sinara-hw/Sayma_AMC/MC100EP_levels.PNG

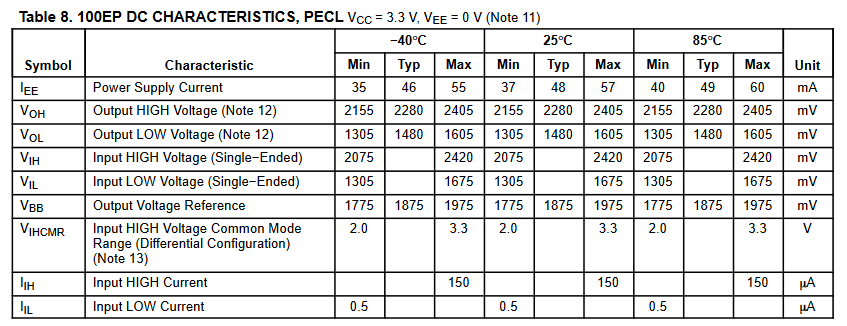
MC100EP_levels.PNG
