sinara-hw/Sayma_AMC/TPS53353-layout.tif

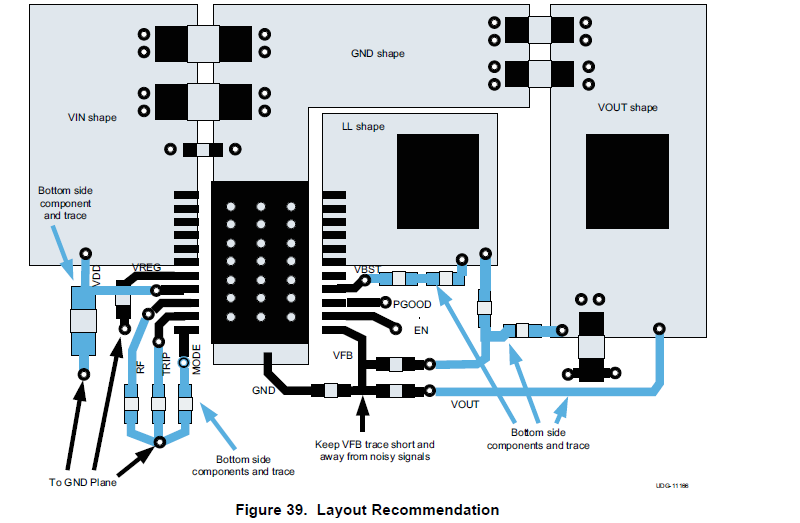
TPS53353-layout.tif
