sinara-hw/Sayma_AMC/TPS53353.png

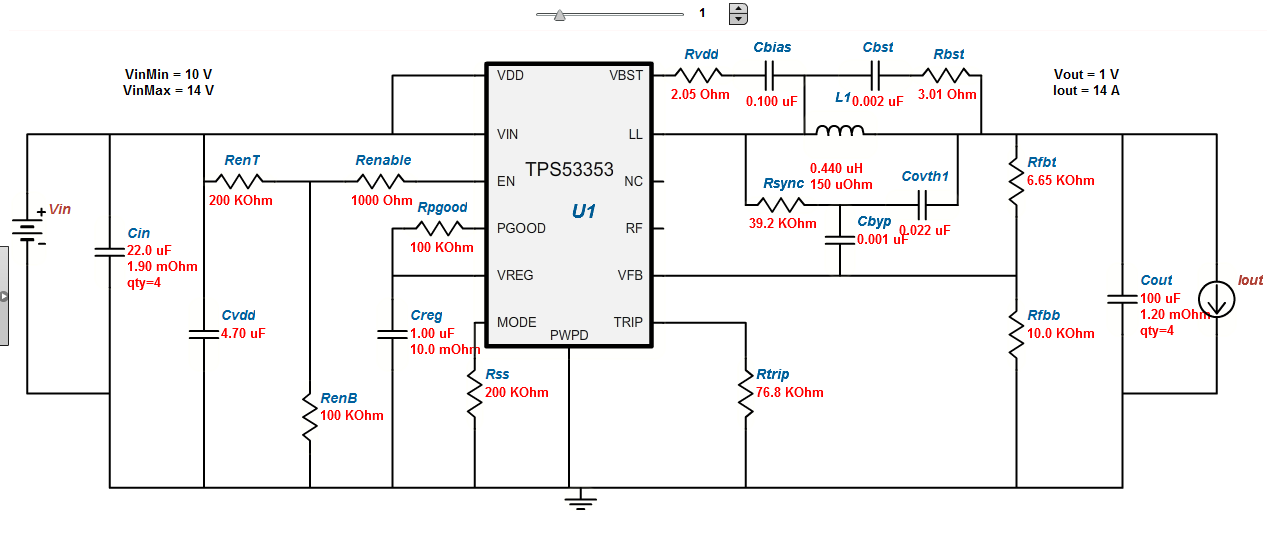
TPS53353.png
