sinara-hw/Sayma_AMC/(threads)

Thread 60 (2017-05-30):

Sayma AMC - Version 1 errata

gkasprow, 2017-05-30:
Mechanical:
- [x] use 2mm higher J14 connector.  Wurth 621 010 210 21
- [x] add cutout in the panel under SFP cage to make module removal easier
- [x] make 3.5mm switch hole in front panel
- [x] panel switch hole = 3.5mm
- [x] sfp cutout 0.5mm bottom
- [x] make USB connector hole touch panel edge
- [ ] move L23 away from ufl connector
- [x] Move power supply status LEDS from bottom side of board to top edge of board (like on Sayma_RTM) so that they're visible from top of crate.

BOM:
- [x] mark R257 DNP
- [ ] add SMA insulating washer to the panel
- [x]  wrong type of guiding socket  - should be "1" instead of '8'
- [x] IC24=DNP
- [x]  R183=DNP
- [x]  remove C282
- [x] AMC: make C221 0R to enable internal reference
- [x] install R507 by default
- [x] Include FMC standoffs and screws in BOM.

I2C:
- [x] connect some I2C pullups to P3V3 instead of P3V3MP

JTAG:
- [x]  add 0R resistors on SWD/JTAG or FET that disconnects SCANSTA during CPU flashing
- [x] add JTAG MPSEL status/control to MMC pin E8
- [x] fix issue with JTAG switchover. After changing MMPSELB1/B0 SCANSTA needs reset to apply settings
- [x] to enable FLASH programming operation, disconnect it from RTM FPGA. Add termination.
- [x] fix second FLASH CSn connection - use pin G26 for CSn instead of K21

USB:
- [x] T23 source = GND
- [x] Insertion/removal of USB cable resets MMC and power supply. Feature: add RC delay circuit or voltage supervisor. Quick fix: jumper on reset signal on T21
- [x] 100k resistor on T23 gate

Ethernet:
- [x] Make sure that TX CLK goes first before Ethernet PHY reset. Feature: trigger it by CONFIG DONE or leave as it is.
- [x] MAX PHY need to have clock delivered to both MII TX CLK and GTXCLK
- [x] make sure that PHY TRSTn is low
- [x] make sure that PHY LOS is low
- [x] Apply Etheret fix #327

Power:
- [x]  feature: add slow start for P12V FMC and RTM 1k5 + 1uF
- [x] add slow start MOSFET in parallel to the current limiting resistor.
- [x] add 3v3mp LED
- [x] add 12V ext TVS
- [x]  LD11 current too low, R242 = 10k
- [x] increase the VCCINT to 0.975V
- [x] 0.9V generation - R243+R244=5k1
- [x]  swap PSIO2 and GPIO0 - resistors R208, R205

Schematics:
- [x] MAX6642 address is 0x48, not 0x24 - change schematic annotation
- [x]  fix schematic symbol of SATA connector - pins numbering
- [x]  RTM IC40 address is 0x4B - change comment on schematics
- [x] Fix illegible blocks in schematic (cf  #231)
- [x] Zero-index all channels (SMAs, FMCs, SFPs, etc)
- [x] Rename USR_UART_P/N - UART is not a differential signal

Clocks:
- [x] OSC3 = 510BBA200 instead of 510ABA200 or add 2x200R to GND
- [x]  wrong connection of SD pins of LTC6957. They must be tied low instead of high.
- [x] re-route Si5324 clocks so CLK1 and CLK2 have same skew - are connected to clock buffer.

Other:
- [x] Assign clock capable pins on FMCs
- [x] wrong pin numbering on J13 silkscreen
- [x]  swap T20, T21 drains or gates
- [x] 10k pullup on SFP pin 9
- [x] The SMA_IO1_DIR MOSFET incorrectly controls the SMA_IO2 channel, and vice versa.

RTM:

- [x] replace MAX6642ATT90+T with MAX6642ATT98+T on RTM - change I2C address from 0x48 to 0x4C (already in RTM errata)

hartytp, 2019-03-11:
> There are only mechanical and PCB left

Great. Are the AMC/RTM schematics ready to review then apart from the HMC830 active loop filter OpAmp choice?

hartytp, 2019-03-11:
> I'll move it to Sayma_AMC repo

Thanks. While you're at it, would you mind reviewing all other Sayma related issues in the Sinara repo and closing/moving them as appropriate?

Closed 2019-03-25.

Thread 61 (2018-05-07):

SFPs get stuck in Sayma

sbourdeauducq, 2018-05-07:
And pins of the cage get bent during removal. See the first 3 pins at the bottom of the cages on the picture:
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

gkasprow, 2019-03-25:
I added panel cutout to solve the issue
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

Closed 2019-03-25.

Thread 44 (2018-12-11):

Sayma AMC v2 design changes

gkasprow, 2018-12-11:
Sayma AMC v2 apart from fixing issues reported in #600 undergoes major modifications:
- Ethernet PHY
- Clock distribution with [WR support](https://github.com/sinara-hw/meta/issues/15)
- FTDI JTAG -copied from Kasli
- JTAG switch - copied from Xilinx devkit, but with AMC access

gkasprow, 2019-02-25:
added clock path between CDR and SDRAM banks to enable Xilinx IP using during production tests
#30

gkasprow, 2019-02-25:
added Silabs CDR test points

gkasprow, 2019-02-25:
added TVS #13

gkasprow, 2019-02-25:
the output of Si5324 buffer routed to the bank 226

sbourdeauducq, 2019-02-26:
> the output of Si5324 buffer routed to the bank 226

Which output of Si5324?
Why?

gkasprow, 2019-02-26:
to make sure every GTX can drive DRTIO

sbourdeauducq, 2019-02-27:
I assume you mean the output of the CDR clock mux/distributor IC44.

OK. Not strictly necessary (the JESD transceivers do not need det-lat with the RTIO clock and also can be clocked from the RTM), but fine to have if it's easy and doesn't break anything.

gkasprow, 2019-03-11:
I think we can close it. It's hard to track all changes since the design is so different from v1.

Closed 2019-03-11.

Thread 1 (2018-12-12):

Sayma AMC v2 schematic review

gkasprow, 2018-12-12:
@jbqubit I've just published schematics and sources of Sayma AMC v2. I figured out that only a few files are necessary to open the design. Remaining >1k files are not needed. This reduces significantly required space on github. For some reason previous versions of Xpedition tool needed some of them.

https://github.com/sinara-hw/Sayma_AMC/releases/tag/v2.0rc1

gkasprow, 2018-12-13:
not yet, I will finish RTM till the end of this week. There are a lot of changes. Today I will post Metlino schematics. I'm just doing cosmetics.

gkasprow, 2018-12-13:
I  found and fixed some critical error. I'm just curious if somebody finds it during review :)

gkasprow, 2018-12-13:
in the meantime I found and corrected a few issues:
- error in JTAG switch control logic
- too high helper DCXO output level in case of LVPECL oscillator used
- @tprzywoz found issue with JTAG net labels

hartytp, 2018-12-13:
Schematics look much nicer than the last design revision. New release of EE?

hartytp, 2018-12-13:
@WeiDaZhang please can do you do a full design review of the WR on Sayma AMC?

hartytp, 2018-12-13:
I had a look at this for things that I should review for Sayma AMC. The only things I can see are:
- WR oscillators and related connections (I will not do the transciever/FPGA clocking, that needs to be done by @sbourdeauducq)
- RTM connector pin out

Let me know if anyone is expecting me to look at anything else.

gkasprow, 2018-12-13:
I played manually with font setting during  pdf export :)

jbqubit, 2018-12-13:
Thanks @gkasprow !

hartytp, 2018-12-14:
> RTM connector pin out

https://github.com/sinara-hw/Sayma_AMC/issues/3

> WR oscillators and related connections (I will not do the transciever/FPGA clocking, that needs to be done by

https://github.com/sinara-hw/Sayma_AMC/issues/5

hartytp, 2018-12-14:
@gkasprow one other thing to consider:
- should we replace the FP SMAs with MMCXs? In the last revision I found it a bit of a pain to tighten SMAs because the density of components was so high
- if there we make this switch then let's move the WR clock input to the FP, using an MMCX for that as well

gkasprow, 2019-02-25:
I updated SMAs with MCX

Closed 2019-02-25.

Thread 3 (2018-12-14):

AMC <-> RTM connections

hartytp, 2018-12-14:
- On Sayma RTM v1.0 there are 10 unused diff pairs on the RTM connector. On the AMC these connect to: GTP8RX-GTP10RX and SYNCOUT{1,2}1
- On Sayma RTM v2.0 we will completely remove (i.e. not just DNP) the JESD ADCs. This will free up an additional 11 diff pairs on the RTM that are currently connected to: GTP{0-7}RX; ADC{0,1}_SYNC; FPGA_ADC_SYSREF
- So, assuming I've counted that correctly, that leaves us with 21 diff pairs to play with.
- On Sayma v2.0 we need to connect more IO to the AFE mezzanines for LVDS ADCs etc. I consider this IO to be part of the "core functionality" of Sayma, since localized control loops (e.g. for laser intensity stabilization) are really important in our experiments
- AFAICT it is not possible to use transceiver TX/RX lines as LVDS, so if we want to repurpose the unused GTP RX lines then we will need to move them onto FPGA SelectIO pins (make sure to include a couple of CC/GC pins)
- Side note: I would be (pleasantly) surprised if using 0R resistors to switch these lines between MGT and LVDS will work from a SI perspective, so my assumption is that the choice of MGT v LVDS will not be a matter of population options

Issues that need considering:
1. How many free pins on the FPGA that we can use for LVDS?
2. Are there likely to be other uses for Sayma AMC that would need the GTX lines? e.g. are people likely to want to combine Sayma AMC with a RTM which breaks out these GTX lines to SPFs for use as a WR/DRTIO switch? My guess is that they won't and, in any case, if people do want this kind of switch, it might be easier to use a really simple AMC combined with FMC<->SFP adapters.

Anyway, once we have answers to these questions we can finalize the layout on the RTM connector.

Other notes:
- Let's try to keep as many of the LVDS lines in the same bank as possible to avoid timing issues
- let's try to delay match the LVDS lines
- need at least two CC/GC LVDS lines (e.g. AFE ADCs)
- On the RTM: ensure that routing of LVDS lines is optimized to minimise cross-talk with analog signals (particularly with the DAC RF outputs).
- FAT_PIPE2 is the link to the second MCH slot in the uTCA rack. This will not be used in ARTIQ, so we can steal lines from this.
- see https://github.com/sinara-hw/sinara/issues/414

hartytp, 2018-12-14:
Other comments:
- final pin choice needs a design review by @sbourdeauducq or @jordens to verify that we're doing things sensibly for use with SU-Servo type loops etc
- Assuming that there are banks on the RTM FPGA that work with LVDS signals, we could consider routing some IO to the RTM FPGA and some directly to the AFE mezzanines. Let's wait and see how much IO we have to play with before we make a decision about this

hartytp, 2018-12-14:
Additionally:
- Now that we don't have an HMC7043 on the RTM, what should we do with GT_CLK{1,2}? We could route the 125MHz reference clock from the RTM to the AMC, but it's not clear that would be useful (and in any case, at some point the RTM ref clock should be derived from the AMC via WR so there is no point routing it back again). Or, we could just re-purpose these as additional LVDS IO. This needs to be considered as part of a review of how to drive the transceiver MGTREF pins in Sayma v2.0
- note to self: in the current version of ARTIQ
  - RTM_FPGA_LVDS2 is used for SERWB TX
  - RTM_FPGA_LVDS1 is used for SERWB RX
  - RTM_FPGA_USER_IO is used for SERWB CLK
  - in the new version of ARTIQ, SERWB will not be used, so these lines become general purpose user LVDS IO
  - @gkasprow why is the naming not consistent here? Why is RTM_FPGA_USER_IO not named RTM_FPGA_USER_IO_0?
  - RTM_MASTER_AUX_CLK is not currently used by ARTIQ and I don't think there are any plans to use it in the future. Can we use this as general purpose LVDS for the AFE mezzanines?
  - NB I am judging pin usage in ARTIQ from https://github.com/m-labs/migen/blob/master/migen/build/platforms/sinara/sayma_rtm.py

hartytp, 2018-12-14:
> we can have additional 4 LVDS pairs. They are routed to FatPipe2 because I had not better idea what to do with them

Great!

That's a good start, but I'm greedy and want more :)

e.g. I'd like to be able to put 1 LVDS ADC  on each AFE mezzanine, so two total. Ideally we should have enough IO for 2x (CLK_IN, CLK_RET, 2xSDO) = 8 lines, as well maybe 1-2 extra lines for future use.

--

As I said, there are also a few more LVDS lines we can steal like IO_L22P_T3U_N6_DBC_AD0P_66/IO_L22N_T3U_N6_DBC_AD0P_66 (SYNCOUT11) etc.

Let's rename those all USER_LVDS_X or similar (convention: RTM_FPGA_LVDS_X goes to the RTM FPGA, USER_LVDS_X goes to the AFE mezzanines). Let's make sure we've re-purposed as many IOs as possible for general-purpose LVDS links.

> I would simply connect MGT Rx lines to the analog mezznines.

Do you think SI will be okay once they've gone through the FMCs and onto an FR4 PCB?

Anyway, my preference would be to maximise the amount of LVDS IO we have going to the AFE mezzanines, even if that means loosing a few transceiver lines (realistically, I think it's unlikely that anyone will ever use Sayma with a JESD ADC, so these transceivers are unlikely to be used).

Let's start with the question "what is the most LVDS lines we can use on the AMC FPGA" and then decide about transceivers.

> Take into accout that RTM_FPGA_GTP_Rx1 / TX1 are also LVDS.

If they are LVDS why are they named GTP? I thought that transceivers can't be used for LVDS. If they are just normal select IO pins then let's rename them to RTM_FPGA_LVDS_x.

hartytp, 2018-12-14:
Which transceiver lines will be used for RTM DRTIO?

hartytp, 2018-12-14:
One other thing: I think that LVDS links to the AFE mezzanines are more useful than links to the RTM FPGA.

Once we've decided how many AMC <-> RTM LVDS links we have to play with, we can divide them between AFE and FPGA links.

gkasprow, 2018-12-14:
We can also forward AMC LVDS links via RTM FPGA LVDS IOs as well.

gkasprow, 2018-12-14:
We used LVDS lines to connect to RTM FPGA GTP to stream DRTIO. It is possible, but GTP to GTP is much easier to implement.

jordens, 2018-12-14:
Could you file issues for checking individual questions like the suservo compatibility thing above?

hartytp, 2018-12-14:
> Could you file issues for checking individual questions like the suservo compatibility thing above? And assign to me.

Yes, apologies for the mega issue. Will break out later this weekend.

hartytp, 2018-12-14:
> We can also forward AMC LVDS links via RTM FPGA LVDS IOs as well.

Yes, this was discussed before. We can do this but (a) it's mildly inconvenient since it means changes to the RTM gateware to configure (b) we're currently very short on pins on the RTM FPGA, there aren't enough pins to route all IO via the FPGA (c) for things like fast LVDS ADCs we need to be careful of timings when using FPGAs as buffers.

Essentially, it's possible, but for now I'd prefer to route IO directly to the AFE.

> We used LVDS lines to connect to RTM FPGA GTP to stream DRTIO. It is possible, but GTP to GTP is much easier to implement.

IIRC that was the plan for Sayma v1.0. In Sayma v2.0 DRTIO will be accomplished using transceivers and there will be no DRTIO using LVDS links.

hartytp, 2018-12-17:
In https://github.com/sinara-hw/sinara/issues/564#issuecomment-447679857 @gkasprow said:

> We already have 12 LVDS lines from Sayma AMC FPGA

Which 12 lines are these? I'd like to finalize the RTM <-> AMC connectivity before we start designing the AFE so that I know what we have to work with.

gkasprow, 2018-12-17:
We can  make some of GTP Rx lines double use with capacitor and extend the LVDS count to 12 lines.

jbqubit, 2018-12-18:
>IIRC that was the plan for Sayma v1.0. In Sayma v2.0 DRTIO will be accomplished using transceivers and there will be no DRTIO using LVDS links.

I'm talking with @sbourdeauducq by email about this. He can provide details. DRTIO will be via transceivers on Sayma v2.0.

gkasprow, 2018-12-18:
So far I assigned only 2 LVDS lines to the RTM FPGA and rest of them routed to AFE

gkasprow, 2019-02-25:
I think we can close it.

Closed 2019-02-25.

Thread 4 (2018-12-14):

Schematics cosmetics:

hartytp, 2018-12-14:

marmeladapk, 2018-12-17:
I'll add some points from https://github.com/sinara-hw/sinara/issues/209 schematics section that are not resolved:

- [ ] IC40 looks like 0x49 on old RTM schematics (address is changed in AMC table to 0x4B)
- [ ] not zero indexed:
 - uart on top
 - fat pipie (though port0 - port3 may be fat pipe 0)
 - SMA I/O
 - CDR_CLK_CLEAN
 - FMC
 - SFP
- [ ] USR UART not renamed

marmeladapk, 2018-12-19:
I think, that this issue could aggregate issues, that could be fixed after boards are send to manufacturer as these have no effect on layout.

Other cosmetics:

- [ ] Exar GPIO0: general input -> general output?
- [ ] Exar: HW_PWR_good net is used now as enable signal
- [ ] P0V9 should be probably renamed to P0V95 (but net P0V95 already exists, could it be merged? VCCBRAM seems to have low current draw, at least 31 mA is noted on schematics)
- [ ] no notes about softstart settings, reset thresholds, R509 which is DNP and what happens if we insert it,
- [ ] no maximum current noted on molex 12V connector

tprzywoz, 2018-12-20:
JTAG_Configuration:
- [ ] Net label FMC1_PRSNT -> FMC1_PS# (like RTM_PS#)

marmeladapk, 2018-12-21:
- [ ] OSC3 has no value or part number

atcher0, 2018-12-21:
- [ ] USB SERIAL QUAD page is described as sheet 31 of 30; DUAL_IO_TTL_BUFFER page is not numbered
- [ ] OSC4_PWR labeled net is connected to OSC2; OSC3_PWR net is connected to OSC1
- [ ] many MMC not connected pins are not marked NC
- [ ] ETH2_RGMII bus is not zeo-indexed
- [ ] no notes about IC11, IC12 direction settings, FT4232H hard-wired settings, TPS3808 voltage threshold
- [ ] USB_JTAG bus should be marked as INOUT not OUT (JTAG configuration page)
- [ ] PHY_CFG bus should be marked as INOUT not IN (MDIO - INOUT; MDIO_MODE - OUT) (ETH PHY page)

marmeladapk, 2019-01-07:
- [ ] ADCLK948 Q4 and Si5324 CKOUT1 are not marked NC

tprzywoz, 2019-01-08:
Change position of AMC_ADD and AMC_En net labels
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

Thread 5 (2018-12-14):

WR connections

hartytp, 2018-12-14:
- @gkasprow what is the additional cost of making J34 + J35 MMCX instead of UFL? Makes the connections a bit more robust
- @gkasprow why does it say "NOT USED" by IO_L24{P,N}_T3U_N1{0,1}_66? These are used for the recovered clock.
- not important, but on the current Kasli schematics we don't connect to Si5324 INT_C1B. On Sayma you connect that to the AMC FPGA. AFAICT, we don't need this line, so we could drop it to save an FPGA pin.
- currently, the Si5324 CLKOUT1 is not connected to anything. Should we connect that to an FPGA MGTREF pin? Now that we don't have the HMC7043 on the RTM, we don't have a programmable clock source to generate the transceiver clock (due to limitations of the transceiver PLL, we may need different clock frequencies for different JESD line rates). @sbourdeauducq should make a decision on this
- @gkasprow what is AMC_TELECOM_CLOCK?
- replace 100k resistor to ground by J3 with 0R
- thinking about this a bit more, I'm concerned that the decoupling between the decoupling between the various P3V3_CDR supplies. The helper DCXO runs at a different frequency to the master, so any power-supply rail coupling will add close-in spurs onto the master. Similarly, if the Si5324 is used to drive a MGTREF, it could be used to produce a different frequency to the WR PLL. I think the best approach would be to produce the circuit the way it is, test it carefully when the boards arrive and only add more filtering/LDOs if we find an issue. On the other hand, an extra LC filter is cheap and may avoid issues. What do you think @gkasprow
- the divider for the main DCXO is not correct. With the connections you have, the ADCLK948 internal 50Ohm termination is enabled, so the 200Ohm source impedance will give quite a low signal. Either disable the ADCLK948 termination (but then be careful about the distance between the DCXO an ADCLK948) or use a smaller source impedance.
- for the helper DCXO please add a note indicating which logic standard and termination should be used. I assume you want this to be used with unterminated LVCMOS? If so, then be careful in the layout to avoid a long length of unterminated trace

Notes on my review:
- [x] Si5324 connections look good (match Kasli)
- @WeiDaZhang are you happy with the FPGA pin used to drive REC_CLOCK?
-

marmeladapk, 2019-01-07:
Helper DCXO doesn't go to 2,5V bank as indicated in the note, it goes to HP. Output divider should probably also be changed.

marmeladapk, 2019-01-07:
Why does helper DCXO have different short to ground (_N line) than main DCXO?

marmeladapk, 2019-01-07:
IC40 OE should be connected as in IC39 (R383 connected to the left side of R385)

marmeladapk, 2019-01-07:
Should IN_SEL (ADCLK948) have pull-up/down resistor to select default?

tprzywoz, 2019-01-09:
As @marmeladapk said Helper DCXO go to 1.8 V bank, not 2.5 V.
Also Helper has both: DC coupling and DC bias voltage on FPGA input.

gkasprow, 2019-02-25:
>     * @gkasprow what is the additional cost of making J34 + J35 MMCX instead of UFL? Makes the connections a bit more robust

the same, done

>
>     * @gkasprow why does it say "NOT USED" by IO_L24{P,N}_T3U_N1{0,1}_66? These are used for the recovered clock.

fixed

>
>     * not important, but on the current Kasli schematics we don't connect to Si5324 INT_C1B. On Sayma you connect that to the AMC FPGA. AFAICT, we don't need this line, so we could drop it to save an FPGA pin.

It's already routed.
>
>     * currently, the Si5324 CLKOUT1 is not connected to anything. Should we connect that to an FPGA MGTREF pin? Now that we don't have the HMC7043 on the RTM, we don't have a programmable clock source to generate the transceiver clock (due to limitations of the transceiver PLL, we may need different clock frequencies for different JESD line rates). @sbourdeauducq should make a decision on this

we use HMC7043.
Shall I connect it to CLK1 of bank 226?

>
>     * @gkasprow what is AMC_TELECOM_CLOCK?
It is a clock delivered by MCH. In our case, it is delivered by WR  timing module that sits on the MCH.
>
>     * replace 100k resistor to ground by J3 with 0R

done

>
>     * thinking about this a bit more, I'm concerned that the decoupling between the decoupling between the various P3V3_CDR supplies. The helper DCXO runs at a different frequency to the master, so any power-supply rail coupling will add close-in spurs onto the master. Similarly, if the Si5324 is used to drive a MGTREF, it could be used to produce a different frequency to the WR PLL. I think the best approach would be to produce the circuit the way it is, test it carefully when the boards arrive and only add more filtering/LDOs if we find an issue. On the other hand, an extra LC filter is cheap and may avoid issues. What do you think @gkasprow

I added already L18 and L19 and 4.7uF || 1nF caps
We don't need low-frequency filtering, do we?

>
>     * the divider for the main DCXO is not correct. With the connections you have, the ADCLK948 internal 50Ohm termination is enabled, so the 200Ohm source impedance will give quite a low signal. Either disable the ADCLK948 termination (but then be careful about the distance between the DCXO an ADCLK948) or use a smaller source impedance.

changed to 49R9

>
>     * for the helper DCXO please add a note indicating which logic standard and termination should be used. I assume you want this to be used with unterminated LVCMOS? If so, then be careful in the layout to avoid a long length of unterminated trace

True, we use 1.8V LVCMOS. That's why 150R + 200R divider was used.
But it has a roughly 80Ohm output impedance.
The diff pair with one line grounded would have similar impedance, so that should work.

>

gkasprow, 2019-03-05:
I think we can close it.
The free clock output of Si5324 has other phase relationship than currently used one.
Moreover, we have 2 clocks connected between and bank 225 and 224
I also routed another copy of CDR clock to bank227 to enable clocking of all MGTs.

sbourdeauducq, 2019-03-05:
>  The free clock output of Si5324 has other phase relationship than currently used one.

Yes, it is important that all clocks should be derived from the *same* Si5324 output. Except in very special circumstances, the two outputs have a random phase relationship with each other after each Si5324 reboot.

Closed 2019-03-05.

Thread 6 (2018-12-17):

Servo AMC<->RTM connectivity requirements

hartytp, 2018-12-17:
Let's make sure that the AMC<->RTM connectivity is designed to support a SU-Servo type application, using the AFE ADCs to feedback onto the RF amplitude/phase/frequency.

NB software/gateware development is not funded for this. This issue is just about making sure the hardware can support this

jordens, 2018-12-18:
That would be great.
If the ADC is the same as on Sampler and is connected to the AMC FPGA, make sure that CLKOUT is a CC pin and that the SDO[ABCD] pairs are on the same bank as that pin. And signal levels and SI.
A sufficiently thorough design review and sign-off of the feasibility of the ADC use cases needs more discussion and specification. And funding.

hartytp, 2018-12-18:
Thanks for the clear summary @jordens

Given M-Labs current limited resources for design reviews, shall we assign checking this to Creotech / @marmeladapk. Reiterating the above, the things to check are:
1. we ideally need 12 LVDS links from the AMC FPGA to the RTM AFE mezzanines (2x{CLKIN, CLKOUT, SDO{A-D}}). It's probably okay if less IO is available, but it needs to be flagged during the high-level review and discussed
2. Check that all LVDS IO for each mezzanine is connected to the same bank of the AMC FPGA and that at least 1 CC pin is routed to each AFE mezzanine
3. Verify SI from the AMC FPGA to the AFE mezzanine is good for DDR signals at 125MHz.

jbqubit, 2018-12-18:
Thanks for the summary @hartytp!!

marmeladapk, 2019-01-28:
It seems that we have enough pins, however checking bank connectivity on AMC needs to wait until #34  is resolved.

gkasprow, 2019-03-06:
We have more LVDS than we need.

Closed 2019-03-06.

Thread 7 (2018-12-17):

Transceiver clocking

hartytp, 2018-12-17:
- How do we want to clock the AMC transceivers?
- more generally, are you happy with the clock connections on the AMC<->RTM connector? Do you want any other clock lines between the two boards? If so, what should they connect to?

gkasprow, 2018-12-17:
So far there are 2 clock input to the AMC MGTs + one general clock input for FPGA GC routed to the clock fanout on RTM.

gkasprow, 2018-12-17:
we can route it to the Si5324 input. Does it support zero skew buffer mode ?

gkasprow, 2019-02-25:
I added output of ADCLK948 to the free input of bank 226.

Closed 2019-02-25.

Thread 8 (2018-12-17):

AMC <-> RTM FPGA connectivity

hartytp, 2018-12-17:
This has been covered a bit in other threads, but we need to make sure that we have all the AMC FPGA <-> RTM FPGA connectivity that M-Labs want. This includes both allocating lines on the AMC <-> RTM connector and ensuring they are connected to appropriate FPGA pins.

gkasprow, 2018-12-17:
at the moment we have 2 LVDS pairs + 1 MGT pair.

gkasprow, 2018-12-18:
I managed to route 16 LVDS lines between AMC FPGA and mezzanines + 2 LVDS lines between AMC FPGA and RTM FPGA

gkasprow, 2018-12-18:
some of them would be shared with MGT Rx lines. So one can use them either as LVDS or JESD204B without issues, just by replacing capacitors.

gkasprow, 2018-12-18:
Let's route all 16 MGT Rx lines as LVDS or MGT.
I still have 7 LVDS lines that would be left as they are. In this way one can place on mezzanine even 8-lane JESD204B ADC when needed or decent speed serial ADC, i.e. 4x125MHz which needs 10 LVDS lanes.

hartytp, 2018-12-18:
Nice! Do we still have a transceiver to use for DRTIO?

Can you post a shot of the schematic with the AMC FPGA pin mapping for the AMC<->RTM connector, please?

> So one can use them either as LVDS or JESD204B without issues, just by replacing capacitors.

Cool. What frequency will that work up to?

gkasprow, 2018-12-18:
I will post once I make sure that I implemented changes on AMC, RTM and BaseMod.
It will work up to 1.5Gb/s easily, depends on speed grade.
I want to remove LVDS connection between FMC DP lane. We won't use it anymore and I will get GC inputs needed for AFE mezzanines. In this way we will get 8 fixed LVDS links + 16 shared with MGT lanes.
A lot of options to explore.

hartytp, 2018-12-18:
@gkasprow naming for these LVDS/MGT signals. Can we call them `LVDS_N`, appending `_CC` for any CC pins, and starting numbering from 0?

gkasprow, 2018-12-18:
I already did that.
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

hartytp, 2018-12-18:
@gkasprow since Sayma AMC may be used with other RTMs, let's try to keep the signal names a bit more generic. E.g. on some future RTM the LVDS lanes may not connect to an AFE mezzanine (there may not be an AFE mezzanine). Let's just name them by the signal type, so `LVDS_0` etc

hartytp, 2018-12-18:
Other than that, looks good!

FWIW, I still suspect that we can scrap AMC_MASTER_AUX_CLK since there is no HMC7043, but @sbourdeauducq should confirm what he wants to do here (is it worth routing a reference clock between the AMC and RTM for debugging, or are we happy to rely on the clock recovery)?

gkasprow, 2018-12-18:
We will have REF clock routed to AFEs anyway, so once we install serial LVDS ADC, it will generate its own copy of the clock. We have GTP clocks anyway. The only clock that may make sense is to route clock from Sayma AMC CDR to clock mux on RTM side and for this purpose we may use these signals .

hartytp, 2018-12-18:
> The only clock that may make sense is to route clock from Sayma AMC CDR to clock mux on RTM side and for this purpose we may use these signals .

Yes, I think that's right.

I don't think there is any point routing the RTM reference clock to the AMC FPGA, since the AMC FPGA will be clocked from the CDR clock.

We could imagine wanting to route the AMC CDR clock to the RTM clock mux in case there is some issue with the WR clock recovery. I suspect that there isn't much point doing this because the cross-talk in the AMC<->RTM connector will be quite bad, so this will not be a low-noise clock.

So, I think we can just scrap the `AMC_MASTER_AUX_CLK` signal and use it as general purpose LVDS/LVCMOS IO for the AFEs. I'm just giving @sbourdeauducq a chance to object and tell us if he needs a clock routed between the AMC and RTM.

gkasprow, 2018-12-18:
Do we care about AMCP2P link? I had free LVDS links so routed them to dedicated links between neighbouring AMC boards (PORTS 12...15).
No idea what it could be used for. The same with FatPipe2 which I already removed.
LVDS over FatPipe1  (Fabric E) makes some sense because we can assign LVDS links on Metlino and run second DRTIO channel over it.

hartytp, 2018-12-18:
> Do we care about AMCP2P link?

In principle, one could imagine using that for fast feedback/feedforwards between cards without involving DRTIO. For example, one could imagine a fast ADC AMC being used to modulate Sayma RF.

In practice, I'm not aware of any plans to do that (we will generally keep that kind of feedback local to an AMC/RTM pair) and don't think it's likely that we will do it.

Personally, I think that if we're short of IO then it's more useful to route IO between the AMC and RTM than to route it between separate AMCs, so I'd scrap the AMCP2P links.

gkasprow, 2018-12-18:
We are not short, I still have some SSTL15 pins in SDRAM bank. It's matter of routing them later on. Schematic is the easiest part, adding signals to already routed BGA is often tricky.

gkasprow, 2018-12-18:
I can leave 2 pairs instead of 8 pairs as it was in rev1.

hartytp, 2018-12-18:
ACK. Well, I don't think it's at all likely that we will use these signals, so I wouldn't bother routing them (let's just focus on optimising the SI for the signals we will actually use, as well as PI etc).

gkasprow, 2018-12-18:
OK, so remove them all.

gkasprow, 2018-12-18:
Anyway, removing connections that are not necessary, makes board far easier to test. In production test suite we test all testable electrical connections so the fewer of them, the better. Development of tests takes time and resources. And also increases the chance that board will fail such test. So keep it simple.
In proto version we added a lot of features mainly to see what is really needed.

gkasprow, 2018-12-18:
I re-assigned some FMC signals and now we have total 27 of LVDS lanes.
3 of them are CC
19 of them including 2CC are in same bank
I routed 3 of them (one CC) to RTM FPGA
Remaining 24 lines will be distributed:
- 8 lanes with 2xCC routed to RTM directly and then to AFE
- remaining 16 routed as 0R assembly option to MGT Rx lanes. Populated to support LVDS by default.
So even if we decide to go for AFE with 8x JESD204B, we would still have 4 LVDS to implement control signals.

gkasprow, 2018-12-18:
This should work
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

gkasprow, 2018-12-18:
we can even move the DAC control lines to banks 47/48 and have all AFE signals in same bank. But I'm not sure we want to move DAC sync lines to the bank without CDR clock... That's why I kept them in this bank

hartytp, 2018-12-19:
Thanks @gkasprow we're getting there. There are a few final things that we need to do to complete this:
- [ ] Let's not name LVDS/MGT signals by their destination/use, but only by whether they're LVDS of MGT. e.g. `RTM_FPGA_LVDS` should just be `RTM_FPGA_LVDS`. The reasoning for this is that Sayma AMC may be used with many different RTMs, so we shouldn't encode the use in the signal names on the AMC. e.g. for the next HW revision, we may want to keep the AMC the same but change how these signals are used on the RTM. Same goes for the transceivers, just name them by signal type and number, not end use.
- [ ] @sbourdeauducq needs to confirm this, but I believe we can remove the `GTP_CLK` signals from the AMC<->RTM connector. In the next revision there will be no HMC7043, so there is nothing to drive these signals. Let's just make them more LVDS IO.
- [ ] There is nothing special about the FPGA_DAC_SYSREF signal, it's just more LVDS, so let's just name it `LVDS_N`
- [ ]

hartytp, 2018-12-19:
- [ ] Don't we need the WR SMA reference connected to the same bank as the helper DCXO. I can't see that on the schematic.

hartytp, 2018-12-19:
> we can even move the DAC control lines to banks 47/48 and have all AFE signals in same bank. But I'm not sure we want to move DAC sync lines to the bank without CDR clock... That's why I kept them in this bank

Let's leave this as it is. We now have more than enough LVDS IO, so no need to worry about this.

hartytp, 2018-12-19:
Other than that, looks good!

gkasprow, 2018-12-19:
OK, the schematic is cut and it doesn't show the WR SMA input. It is connected to GC in bank 47. I can move it to same bank as WR clocks, but it won't be GC. But I think we don't care, do we?
I mean that FPGA_DAC_SYSREF is routed to DAC while other signals are user-defined., I don't want to change the signal name because it leads to confusion.

gkasprow, 2018-12-19:
> Let's not name LVDS/MGT signals by their destination/use, but only by whether they're LVDS of MGT. e.g. RTM_FPGA_LVDS should just be RTM_FPGA_LVDS. The reasoning for this is that Sayma AMC may be used with many different RTMs, so we shouldn't encode the use in the signal names on the AMC. e.g. for the next HW revision, we may want to keep the AMC the same but change how these signals are used on the RTM. Same goes for the transceivers, just name them by signal type and number, not end use.

I'm not sure I follow you  here. The signals are called LVDSxx and they enter the RTM connector via resistors. They are grouped into the bus RTM_LVDS_IO. FPGA pins are called LVDSxx.
The MGT signals are called GTxxRX/TX and are grouped into the bus RTM_GT. They enter the RTM connectors via DNP capacitors.

hartytp, 2018-12-19:
> OK, the schematic is cut and it doesn't show the WR SMA input. It is connected to GC in bank 47. I can move it to same bank as WR clocks, but it won't be GC. But I think we don't care, do we?

That SMA doesn't need to be a GC pin or even a CC pin, since it just goes to the DDMTD DFF data input.

Let's prioritise keeping all WR signals in the same bank and as close together as possible.

> I mean that FPGA_DAC_SYSREF is routed to DAC while other signals are user-defined., I don't want to change the signal name because it leads to confusion.

On Sayma v2.0 that's not true. (a) because the DAC SYSREF goes to the DFF + delay line and before the DAC and (b) because we will probably use the RTM FPGA to generate the DAC SYSREF signal. From my point of view, it's best to just name these signals by their logic levels so that the schematic does not become incorrect if we change how these signals are used on the RTM.

hartytp, 2018-12-19:
> I'm not sure I follow you here. The signals are called LVDSxx and they enter the RTM connector via resistors. They are grouped into the bus RTM_LVDS_IO. FPGA pins are called LVDSxx.
The MGT signals are called GTxxRX/TX and are grouped into the bus RTM_GT. They enter the RTM connectors via DNP capacitors.

I mean, let's rename the signal `RTM_FPGA_LVDS` to just `LVDS`. That way if we reroute these signals on the RTM, the AMC schematic does not need to be changed.

hartytp, 2018-12-19:
Similarly, I'd call `RTM_FPGA_GTP` just `GTP`

gkasprow, 2018-12-19:
oh, you mean the bus name. OK

gkasprow, 2018-12-19:
OK, you mean the signal that goes to the Artix chip

gkasprow, 2018-12-20:
Schematics with fixes
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

we still have 2 LVDS pairs on FPGA without RTM assignment.

hartytp, 2018-12-20:
@gkasprow Good thanks. I'm happy to close this issue now. Some final comments from me:
- I'm not reviewing things like RTM JTAG, so I assume someone else is checking that (I noticed that one JTAG line does not connect to anything on the RTM connector)
- It's not crucial, but is there a reason not to merge the RTM_GT and RTM_FPGA_LINK busses into a single RTM_GT bus? Again, the point here is that as far as the AMC is concerned it's all just MGT. It's up to the RTM hardware designer to decide how it's used, but that shouldn't be prescribed in bus names on the AMC. If there is some reason that it's hard to merge these busses in the schematic then it's fine to leave them as they are.
- I don't think we need the 2 GTP clock lines anymore since there is no HMC7043. However we now have more than enough IO so it's fine to leave them there if you want.

sbourdeauducq, 2018-12-20:
> FWIW, I still suspect that we can scrap AMC_MASTER_AUX_CLK since there is no HMC7043

Yes, we can remove it. It is disabled in the current firmware.

As for removing GT clock links from RTM to AMC, there are two things to check:
* is the jitter low enough for JESD204 to work at the maximum clock speed? I suppose those transceivers would be clocked from the Si5324?
* all clock pins (Si5234 and WR) must be able to drive all JESD quads and all DRTIO quads (for AMC backplane DRTIO, RTM DRTIO, and SFP DRTIO if we support that). On Ultrascale, a transceiver clock pin can drive its quad, and the two quads above and below it (max 5 quads from one clock pin).

gkasprow, 2019-02-25:
bank 224 has all DRTIO links. It can be driven by Si5324 directly. Or can be driven by GTCLK0 via RTM side and bank 226.
I added a connection between Si5324 and bank 226 clk1. In this way, Si5324 would be able to drive JESD as well.

Closed 2019-02-25.

Thread 9 (2018-12-17):

BOM verification

atcher0, 2018-12-17:
BOM: https://octopart.com/bom-tool/L1u7kYdF

Elements out of stock:
- N25Q256A13ESF40 (256Mb, 2.7 to 3.6V, Multiple I/O Serial Flash Memory) - IC1-IC3

Elements with low avability / near end of life:
- BSH103 (30V 850mA N-Channel Enhancement Mode Field-Effect Transistor) - T1-T6
- 549CBAC000112ABG (Ultra Low Jitter I2C Programmable XO (95 fs), 0.2 to 250MHz) - IC39,IC40
- 62101021021 (WR-PHD 1.27 mm SMT Dual Pin Header, H=3.80 mm) - J36
- MT41J256M16HA-125:E (DDR3 SDRAM) - IC22-IC27
- 342947 (COPPER HEATSINK 57.9X59X11MM) - HS1
- XCKU040-1FFVA1156C (Kintex UltraScale FPGA, 520 I/O, 530K Cells, 1156-Ball BGA, Speed Grade 1, Commercial Grade) - IC37

Notes:
- I assumed that 88E1512-XX-NNP2I000 is the same as 88E1512-A0-NNP2I000 (ETHERNET PHY)
- TCM2-43X+ is available only directly from Mini Circuits

jbqubit, 2018-12-18:
Thanks @atcher0! I'm inquiring with Xilinx as to why XCKU040-1FFVA1156C has such poor availability.

gkasprow, 2018-12-18:
Large FPGAs have usually large lead time and are assigned and delivered on per-project basis.

atcher0, 2018-12-20:
- [ ] include FMC standoffs and screws in BOM
- [ ] include SMA insulating washers in BOM

gkasprow, 2019-02-25:
@sbourdeauducq @jordens I will use
MT25QL256ABA8ESF-0AAT  as FLASH
and MT41K256M16TW-107:P.

marmeladapk, 2019-04-12:
TPS53353DQPT doesn't have manufacturer part number.

Closed 2019-04-28.

Thread 14 (2018-12-20):

FP connections

hartytp, 2018-12-20:
Since we're now using MCX elsewhere, can we switch the MMCX connectors on Sayma AMC for MCX please (assuming there is room)? Thanks and apologies for the last minute switch!

jbqubit, 2019-01-09:
@gkasprow @marmeladapk Can this change be accommodated? Seems like it's a trivial change but it does modify the BOM.

hartytp, 2019-01-09:
To clarify, on v1.0 there were 2 SMA connectors on the FP. That didn't really work since they clashed with the USB connection and uTCA handle. This made them a PITA to use.

In the initial v1.2 schematic they were replaced with MMCX to solve these mechanical issues. Proposal here is to replace with MCX...

gkasprow, 2019-01-09:
We have more place with FMC panels so it should be easier.

gkasprow, 2019-01-09:
ups, U are talking about AMC..true, we can replace with MCX ones

hartytp, 2019-01-09:
Yes, I mean on the AMC. Those SMAs always made me swear every time I used them.

I think it's also worth replacing the MMCXs on BaseMod with MCXs where possible to improve the mechanical reliability and compatibility with other boards, but that's a separate issue.

gkasprow, 2019-02-25:
MCX won't fit on BaseMod,
I replaced SMAs with MCXs on the AMC.

Closed 2019-02-25.

Thread 16 (2018-12-20):

ground coax connector shields

jordens, 2018-12-20:
* short R1
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

Closed 2019-02-25.

Thread 17 (2018-12-20):

connect I2C switch reset to FPGA

jordens, 2018-12-20:
Having to reload the FPGA is annoying. With a bit of software support, this can recover from I2C hangs due to breakage on SFPs, FMCs, RTMs.
IC53
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

We might also want to connect the I2C bus to the FTDI chip like on Kasli. Maybe one VUART bus could go.

gkasprow, 2019-02-25:
added I2C_SW_FPGA_RESETn to ball M15 of FPGA.
Isn't one VUART used to talk with RTM FPGA?

Closed 2019-02-25.

Thread 19 (2018-12-20):

[needs checking] GTH quad number clock constraints

jordens, 2018-12-20:
With the clocking tree I am a bit uncertain which clock is doing what currently. @hartytp @sbourdeauducq could you confirm the rolses of the clocks?

* The clock that will drive the JESD GTHs should be central in the 4 JESD quads. If it's GT_CLK2_IN_N and GT_CLK1_IN_N the assignment is ok.
* The clock for SFP/AMC also needs to be within 2 quads of the SFP/AMC quad. If all their clocks are on Quad 224, that's ok. Only GT_CLK1_IN_N can clock Quad 224, GT_CLK2_IN_N can not.

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

jordens, 2018-12-20:
https://github.com/sinara-hw/Sayma_AMC/issues/8#issuecomment-449038059

hartytp, 2018-12-21:
> With the clocking tree I am a bit uncertain which clock is doing what currently. @hartytp @sbourdeauducq could you confirm the rolses of the clocks?

@jordens I think this one is best left to you and @sbourdeauducq since you know far more about transceiver clocking than me.

FWIW, my thoughts on your comments would be:

>  If it's GT_CLK2_IN_N and GT_CLK1_IN_N the assignment is ok.

Currently there is no plan to add a synth on the RTM to drive those. We could drive them directly from the RTM reference clock, but I don't think that works for all line rates due to the FPGA PLL limitations.

So, I think we should probably remove these signals from the AMC<->RTM connector and drive them from the AMC directly (e.g. from the spare Si5324 output). But, this decision should be made by someone whose thought more about JESD clocking than I have.

jordens, 2018-12-21:
I'm confused. Isn't the clock clocking concept designed already? I am just asking for an explanation of the intended function and mode of operation of a few of the signals going into and coming out of the clock tree.

hartytp, 2018-12-21:
@jordens to clarify:
- the RTM clock tree is fully designed already as part of the new synchronisation scheme work I did
- when @sbourdeauducq and I discussed the new synchronisation scheme we agreed that the transceiver clocking on the AMC would need some modification because of the lack of the HMC7043. IIRC the conclusion of those conversations was that this shouldn't be a major issue, but it needed some thought, and maybe a new PLL on the AMC (unless we can just use the second output of the Si5324). IIRC we agreed to put thinking about this off until M-Labs had funding for it
- AFAICT, our options are either to use the AMC CDR clock + a PLL like the Si5324, or to use the RTM reference clock (routed via the AMC<->RTM connector) + PLL.

hartytp, 2018-12-21:
>  think there needs to be a CDR. Otherwise there is way to much dependency on the RTM and a correct clock coming from RTM

Yes, I think there needs to be CDR (Si5324 + WR) on both the RTM and AMC.

> We have to make sure that we can bring up and RTIO-clock the RTIO stuff on the AMC without the RTM.

The clocking for Sayma v1.0 was a bit of a mess of interdependencies between the two boards. Hopefully we can do something simpler for v2.0

Closed 2018-12-20.

Thread 20 (2018-12-21):

Connect AMC telecom clock somewhere

marmeladapk, 2018-12-21:
@gkasprow Could we connect telecom clock A through capacitors (DNPed) to ADCLK948 CLK0? This would allow us to use Saymas with WR-MCH without any serious reworks on the board.

marmeladapk, 2018-12-21:
Or to FPGA directly

Closed 2019-02-25.

Thread 24 (2018-12-23):

make sure all transceiver channels can be clocked from uFL

sbourdeauducq, 2018-12-23:
So we can bypass any clocking circuit breakage.

gkasprow, 2019-02-25:
224 cannot but we clock it from CDR and 200MHz oscillator.
225 can be clocked
226 - cannot but we have it connected to RTM and HMC7043. If necessary I can add ufl
227 cannot but we have it connected to RTM and HMC7043 and also DNP oscillator
228 can be clocked

sbourdeauducq, 2019-02-26:
226 should be sufficient no? And there is a spare CLK pin there. https://github.com/sinara-hw/Sayma_AMC/issues/47

gkasprow, 2019-03-05:
OK, moved ufl to 226

Closed 2019-03-05.

Thread 25 (2019-01-03):

check net names are exactly the same on both sides of the AMC<->RTM connector

hartytp, 2019-01-03:

hartytp, 2019-01-03:
Related:
- [ ] Didn't we agree to rename `RTM_FPGA_GTP_{}` to just `RTM_FPGA_GTP` (i.e. same naming as other GTP signals)? If there is no difference between these signals and the other GTP lines on the AMC FPGA then why name them differently. IME it's generally better not to encode the functionality for these kinds of signals in the name (e.g. I can imagine using Sayma AMC with other RTMs which might not connect these lines to an RTM FPGA.)

gkasprow, 2019-02-25:
done

Closed 2019-02-25.

Thread 32 (2019-01-14):

IC58 TPS74401 Vin under recommended voltage range

tprzywoz, 2019-01-14:
IC58 LDO input voltage is 1.0 V.
In Electrical Characteristics minimum Vin is Vout (0,95 V) + Vdo (which is extreamly low thanks to 31 mA load current). But minimum Input supply voltage in Recommended Operating Conditions is 1.1 V.

gkasprow, 2019-03-06:
since VCCINT is 0.95V we don't need it anymore

Closed 2019-03-06.

Thread 33 (2019-01-16):

Clk_recovery LDO

tprzywoz, 2019-01-16:
There should be added another LT3045 (P3V3_CDR) because we exceed output current limit (500 mA).
Worst case for Si5324 + ADCLK948 + 2 x 549CBAC = 863 mA.

gkasprow, 2019-01-16:
ADCLK current depends on a number of loaded outputs. I will check my current estimation

gkasprow, 2019-02-25:
Let's kick away the LDO.
I will add a dual stage LC filter and connect the whole clocking circuit to the P3V3.
When we had only Si5324 I used 5V helper buck (for Exar) to supply it.
Now we have much more stuff- 2 oscillators and ADCLK948. We would have to use a higher current buck and higher current LDO.
Any objections @hartytp ?

hartytp, 2019-02-25:
@gkasprow so the suggestion is to clock all clock recovery components from the P3V3 SMPS? I'd really prefer not to do that if we can avoid it, as I'd worry about coupled noise.

Can we keep an LDO for this revision? Maybe also add a solder jumper that can be used to bypass the LDO, so we can measure the performance with and without the LDO and then consider scrapping it in the next revision once we have some performance data?

hartytp, 2019-02-25:
As you say, a lot of the current estimate for this comes from unused channels on the ADCLK948. The actual worst-case current consumption will be a lot lower than 863mA won't it?

gkasprow, 2019-02-25:
The unused channels don't consume large current until you load them with termination or pulldown.
OK, I will place a stronger buck converter. It is also a lower cost one.
Not worth risking.

gkasprow, 2019-02-25:
I used [TPS78633](http://www.ti.com/lit/ds/symlink/tps786.pdf)

Closed 2019-02-25.

Thread 34 (2019-01-28):

AMC<->RTM connections are from the old version

marmeladapk, 2019-01-28:
@gkasprow TL;DR Overall it seems, that RTM connector sheet on AMC schematics was not changed to reflect new connections on RTM.

Some examples, assuming that pin A1 on AMC connects to A1 on RTM (I gave up after first sub-part):

- [ ] Are you sure, that RTM_FPGA_GTP_Rx/Tx0 on GTH schematics is connected to RTM_FPGA_LINK bus?
- [ ] RTM_FPGA_GTP_Tx1 (LVDS4 on RTM) is DC biased
- [ ] RTM_FPGA_GTP_Rx1 (LVDS1_CC on RTM) is AC coupled unlike other LVDS connections
- [ ] RTM_FPGA_GTP_Rx1 (LVDS1_CC on RTM) is connected to byte-lane clock input, not GC
- [ ] ADC1_SYNC, ADC2_SYNC (LVDS2, LVDS3 on RTM) has swapped polarity
- [ ] RTM_FPGA_USR_IO (LVDS0_CC on RTM) is not connected to CC pin
- [ ] AMC_MASTER_AUX_CLK (LVDS11) is DC biased

Cosmetics:

- [x] Rename nets, so that they resemble RTM connections (e.g. RTM_AFE_LVDS or something like that), right now there are nets like RTM_FPGA_GTP_Tx1, which connect to some LVDS lines on AFE

gkasprow, 2019-02-25:
all LVDS are DC-biased and connected to 3 banks.

Closed 2019-02-25.

Thread 35 (2019-02-22):

recovered clock routing

hartytp, 2019-02-22:
Discussing plans for WR with @sbourdeauducq https://freenode.irclog.whitequark.org/m-labs/2019-02-22

Once concern with WR is the possibility of adding noise to the recovered clock when it is routed inside the FPGA to the DDMTD FFs. The best option seems to have both DDMTD inputs coming from IOs in the same bank. We can then ensure that the FFs are in the IOBs.

In ultrascale FPGAs, the most direct way of accessing the recovered clock is via a MGTREF pin, which can be configured as an output.

Action:
- @gkasprow can you route a MGTREF output to an IO in bank 66? (@sbourdeauducq any preference as to which MGTREF we use?)

@sbourdeauducq what is the best means of accessing the recovered clock on Artiq FPGAs?

cc @WeiDaZhang

gkasprow, 2019-02-25:
ping @sbourdeauducq

sbourdeauducq, 2019-02-26:
>     * @gkasprow can you route a MGTREF output to an IO in bank 66? (@sbourdeauducq any preference as to which MGTREF we use?)

What for?
I mentioned routing a OBUFDS_GTE3 to the *RTM* FPGA (if easy to route and if there are enough pins).
Is this for doing DDMTD tests with a locally-clocked circuit all in Ultrascale?
Maybe we can add uFL connectors to I/Os instead, then add jumper cables to do this experiment?

> @sbourdeauducq what is the best means of accessing the recovered clock on Artiq FPGAs?

https://github.com/sinara-hw/Sayma_AMC/issues/37#issuecomment-466924665

sbourdeauducq, 2019-02-26:
>  I mentioned routing a OBUFDS_GTE3 to the _RTM_ FPGA (if easy to route and if there are enough pins).

Maybe we can just have two uFL that go through the RTM connector and then we can choose to connect them to the MGTREFCLK uFL with jumper cables.
The advantage of going through the RTM connector (instead of having uFL cables between AMC and RTM) is the cards can still be inserted easily into the µTCA rack, and it also looks cleaner.

hartytp, 2019-02-26:
> What for?
> I mentioned routing a OBUFDS_GTE3 to the _RTM_ FPGA (if easy to route and if there are enough pins).
> Is this for doing DDMTD tests with a locally-clocked circuit all in Ultrascale?

Yes, this is for testing the DDMTD/DCXO PLL on the AMC. I think this is a really worthwhile test to do. Apart from potentially being useful for Sayma, it is interesting in its own right -- the CERN literature concludes that the performance of WR is limited by the LVDS IO buffers used in FPGAs. Getting the signal out from the (CML) OBUFDS_GET3 and feeding it into a dual ECL DFF might give substantially better results (or it might not if the OBUFDS_GTE3 turns out to suck). Combining that with the higher-order loop filter we're using and the DCXO (which is a fair bit better than the DAC + VCO used in WR) could give some really nice results. Obviously, that's far less important than getting Sayma up and running, but worth leaving the option open for us to play with this.

> Maybe we can add uFL connectors to I/Os instead, then add jumper cables to do this experiment?

That would be an acceptable option. However, I'd prefer to add a clock fanout if it can be done easily. While we're playing around with different clocking options, it's nice to be able to switch between them in software (e.g. Creotech have expressed a strong preference for this, as they can do automated testing).

Ideally, I'd like to use a fanout to drive the OBUFDS_GTE3 to the AMC<->RTM connector, the DFF, the SI5324 and a diff IO in the same bank as the other WR signals. That way we keep all options open for testing/evaluation. Currently, the recovered clock is routed from an IO to the Si5324, maybe use a mux for the fanout and use that IO as the second input?

sbourdeauducq, 2019-02-26:
> Getting the signal out from the (CML) OBUFDS_GET3 and feeding it into a dual ECL DFF might give substantially better results (or it might not if the OBUFDS_GTE3 turns out to suck).

Yeah sure, but why connect MGTREF to to an *Ultrascale IO pin*?

hartytp, 2019-02-26:
Low priority, but might be interesting to compare DDMTD with the external DFF with DDMTD with FFs in the FPGA. For the internal FF case, it's possible that placing both DDMTD FFs in adjacent IO tiles and routing the recovered clock externally from the OBUFDS_GTE3 to the LVDS inputs will give lower noise than routing the recovered clock internally through the FPGA. Essentially, just trying to give us as many different options for implementing this as possible so we can have a play.

sbourdeauducq, 2019-02-27:
Let's add uFLs. Also for the Ultrascale I/O pin.

Those are just for experiments, not production testing, and the uFLs are easier to layout/route than the muxes and also we can connect them to anything, not only what we had planned to in the beginning.

hartytp, 2019-02-27:
Agreed, we should definitely make sure we connect all critical clocking signals to uFL/MMCX/whatever (e.g. after fanouts). The muxes are low priority, and I'm not overly fussed either way. I'm happy to leave that decision to greg.

sbourdeauducq, 2019-02-27:
To clarify what I mean:
* add differential uFLs on a pair of general-purpose Ultrascale I/Os that support LVDS. Probably with some adapter so we can connect CML there directly. Choose a GC pin just in case.
* add (more?) differential uFLs on a GTREFCLK that can output the DRTIO recovered clock
* add differential uFLs on a pair that goes to the RTM connector
* on the RTM side, add some adapter for CML signals and connect to FPGA I/O with LVDS. Choose a GC pin just in case.
* then we do the routing manually using uFL jumper cables when experimenting with the board.

hartytp, 2019-02-27:
> Probably with some adapter so we can connect CML there directly

Yes, some pads for RC matching elements is a good idea!

gkasprow, 2019-03-06:
done

Closed 2019-03-06.

Thread 36 (2019-02-22):

AMC WR options

hartytp, 2019-02-22:
If I've understood correctly, @sbourdeauducq believes that we will have issues with the AMC WR implementation, even if both DDMTD inputs are from IOs in the same bank as the helper PLL. This is a problem that's unique to ultrascale FPGAs, so won't affect Kasli or Sayma RTM.

We have three options to get around this:
1. Don't bother with WR on the AMC. Route the recovered clock to the RTM via the AMC to RTM connector and do all the clock recovery on the RTM. The main risk here is that we'd be routing a clock at f_RTIO via a connector that is not designed to be low cross-talk/low pick-up. Any noise close to the carrier cannot be removed by the WR PLL.
2. Add a small cheap FPGA to the AMC and implement the WR PLL on that.
3. Add an external dual DFF to the AMC and use that for the DDMTD. We'd have to make sure the FF outputs meet S/H at the AMC FPGA. This shouldn't be an issue at 150MHz, since the DFF timing is very stable over PVT (https://www.onsemi.com/PowerSolutions/product.do?id=MC100EP29) and we should be able to add proper timing constraints. But @sbourdeauducq would want to add some extra S/H violation measurement logic to make sure it's okay. This is doable, but more work on the gateware/software side of things.
4. Kick this into the long grass. Add sufficient MMCX connectors to the AMC that if necessary we can move the clock recovery to a separate card that can be hacked onto the AMC. It can then be integrated into Sayma v2.1 after it's been prototyped on Sayma AMC v2.0.

gkasprow, 2019-02-22:
Does this small FPGA have to handle DRTIO logic as well? Or we use Kintex US CDR clock routed via IO pins to the second FPGA that implements WR?

hartytp, 2019-02-22:
The latter. In detail:
- Kintex CDR clock drives a MGTREF output
- MGTREF output goes to a diff IO on timing FPGA
- helper DCXO goes to a clock pin on timing FPGA
- main DCXO goes to a diff input on timing FPGA (all three in same FPGA bank)
- timing FPGA drives I2C bus with DCXOs on
- timing FPGA runs white rabbit loop clocked at 125MHz (DDMTD, deglitch, loop filter, drive I2C bus)

gkasprow, 2019-02-22:
Would she smallest Artix chip do the job? we can use XC7A15T-3

hartytp, 2019-02-22:
> Would she smallest Artix chip do the job? we can use XC7A15T-3

Would almost certainly be fine. I can get Weida to port his WR code to that and check it meets timing if that helps?

FWIW, I still feel that using an external dual FF is a more elegant approach.

gkasprow, 2019-02-22:
True, additional FPGA means additional code to maintain, extra communication interface, additional cost and possibly supplies. DFF seems to be simpler approach.

hartytp, 2019-02-23:
> True, additional FPGA means additional code to maintain, extra communication interface, additional cost and possibly supplies. DFF seems to be simpler approach.

That's my feeling as well. I suspect a dual-DFF like MC100EP29 will give better performance.

The only concern I'm aware of with that would be @sbourdeauducq's concerns about the DFF output meeting timing at the FPGA inputs due to ultrascale-related issues (which I don't fully understood since I haven't played with that FPGA much). However, I suspect that with proper timing constraints this won't be an issue. And, if it is an issue, then I think we're in all kinds of other trouble (e.g. SUServo won't work on Sayma).

@sbourdeauducq for S/H violation detection, what about driving the DFF S & R inputs from the FPGA. Toggle those pins and check that the FPGA always receives the correct input.

hartytp, 2019-02-23:
Side note: if we go for a DFF on the AMC and Artix-7 IOB FFs on the RTM, it will be interesting to compare the performance. I wonder if we will see better stability with the external FF or not. I'm not aware of anyone having looked at that before...

gkasprow, 2019-02-23:
True, let's go for it.
We can always add a tiny module with an alternative clock approach to the GPIO pins and uf.l clock input.

hartytp, 2019-02-23:
That's what I'd like to do, but we should get @sbourdeauducq to sign off on it.

Give me a day or two to finish writing up the clocking, so we have a clear plan. Then we can get everyone to sign off and freeze the design.

sbourdeauducq, 2019-02-26:
For sending the recovered clock to the FFs I think MGTREFCLK1_225 should work (but we should check that Vivado can compile the design, and also maybe test on the existing hardware that OBUFDS_GTE3 works as expected by looking at MGTREFCLK0_225 on the uFL).

hartytp, 2019-02-26:
@WeiDaZhang Can you adapt your test design to Sayma v1.0 and see if you can measure the noise/stability of the recovered clock on MGTREFCLK0_225 using the available UFL connectors?

@sbourdeauducq do you want a test compilation with ARTIQ, or just with a simple test design that instantiates the transceivers?

sbourdeauducq, 2019-02-26:
Probably easier to use ARTIQ anyway.

gkasprow, 2019-03-05:
@hartytp  I started implementing the discrete DFF approach to the DDMTD.
And the question is if the DFF outputs need to be fed to the same bank as helper DCXO clock?
IMHO not because we don't care about the delay here so much. IMHO they don't need to be DC coupled as well.
In the same bank as helper DCXO, I have only 2 LVCMOS pins. In other banks, i.e. DDR3 one, I have many more pins as well as diff pairs.

sbourdeauducq, 2019-03-05:
Is there good SI when connecting the clocks in parallel like that?

gkasprow, 2019-03-05:
I will place DDMTD very close to the oscillators. so there won't be any stubs.

sbourdeauducq, 2019-03-05:
Another thing - can we have an option (possibly involving soldering, e.g. capacitor selection) to use a general-purpose I/O instead of OBUFDS_GTE3?
In theory, OBUFDS_GTE3 works better than the general-purpose I/O, but there can be surprises...

gkasprow, 2019-03-05:
OK.

gkasprow, 2019-03-05:
We can re-use the REC_CLK signal that already goes to the SI5324. Another option is to route a signal from DDR3 bank.

sbourdeauducq, 2019-03-05:
REC_CLK is fine. I'd rather keep related things in the same bank as much as possible, Ultrascale I/O and clock routing is a bit weird (and poorly documented).

gkasprow, 2019-03-05:
so maybe I should deliver another copy of the Helper CLK to the SDRAM bank, where other DDMTD signals are routed? or convert DDMTD outputs to single ended?

sbourdeauducq, 2019-03-06:
> or convert DDMTD outputs to single ended?

Yes, do that.

hartytp, 2019-03-06:
> And the question is if the DFF outputs need to be fed to the same bank as helper DCXO clock?

No, they don't. We only need to meet timing at 125MHz, but we don't care about a few clock cycles of latency so can always add a few FFs to help timing (although, let's try to minimize the amount of that required).

> I assumed we need to route the helper clock to the FPGA as well because the filter logic will rely on it.

yes.

> We can re-use the REC_CLK signal that already goes to the SI5324. Another option is to route a signal from DDR3 bank.

That's was my plan as well.

> Another thing - can we have an option (possibly involving soldering, e.g. capacitor selection) to use a general-purpose I/O instead of OBUFDS_GTE3?

If we end up needing a fanout buffer for this we can make it a mux, otherwise solder jumpers are fine.

hartytp, 2019-03-06:
> @hartytp please have a look.

Topologically, that looks fine to me. Please just double check that all signals are correctly biassed and terminated and all logic levels (CML/LVDS) are noted on the schematic.

sbourdeauducq, 2019-03-06:
> No, they don't. We only need to meet timing at 125MHz, but we don't care about a few clock cycles of latency so can always add a few FFs to help timing (although, let's try to minimize the amount of that required).

To me it sounds cleaner and easier to just use the same bank and convert to single-ended. The only serious issue with single-ended signals is it may make certain setup/hold validation schemes more difficult or impossible.

hartytp, 2019-03-06:
Works for me.

gkasprow, 2019-03-06:
True, the LVPECL to LVCMOS converters have usually large delay variation.
So let's keep the DDR3 bank inputs. I will add test points to the single-ended inputs.

sbourdeauducq, 2019-03-07:
> True, the LVPECL to LVCMOS converters have usually large delay variation.

How large? Ultrascale FPGAs aren't exactly stable either, **plus** come with obscure Vivado errors and frustration...

sbourdeauducq, 2019-03-07:
For MAX9171/MAX9172 for example, it's 1.5ns maximum, which isn't crazy...
Is it really safe to AC-couple the outputs of those flip-flops? If the "glitchy" behavior isn't symmetric during rising and falling transitions of the DDMTD outputs, the capacitors might introduce some subtle effects. If we use converters, we can perhaps use CML or CML-tolerant ones, and not worry about it...

hartytp, 2019-03-07:
Isn't there an RC network we can use to convert LVPECL to LVCMOS/STL with decent performance?

sbourdeauducq, 2019-03-07:
With capacitor tolerances it might not necessarily be better than the 1.5ns of the MAX part...

hartytp, 2019-03-07:
Well, for DC coupled signals, it's actually probably just a R network. Anyway, component tolerances can be simulated quite quickly.

I don't object to an active solution, just felt that a passive resistor ladder is cheaper/simpler than adding a new BOM line. I don't feel strongly and wouldn't want to hold the design up for this so any method that @gkasprow thinks will work is fine by me...

gkasprow, 2019-03-07:
we can DC-couple to SSTL15 easily using just 4 resistors.
It's hard to DC couple to LVCMOS18 using passive components.
Since you don't care about propagation variation between [900ps and 3ns](https://www.onsemi.com/pub/Collateral/MC100EPT21-D.PDF) so what's the difference if you receive it on same bank or different bank

hartytp, 2019-03-07:
Ouch, that's huge!

It would be nice to have propagation delay that's a bit more stable than that, as it makes some S/H validation schemes easier.

I would have expected that coupling into single-ended SSTL15 with resistors would be really quite stable as long as we don't use overly large resistor values (the rising edges are damn fast).

gkasprow, 2019-03-07:
This solution does the job nicely. It also keeps the output impedance low so there won't be any rise time issues.
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

sbourdeauducq, 2019-03-08:
The MAX part I was mentioning is more stable, and also you get two translators in one chip.

Anyway it's quite hard to decide what solution really is the best:

Active solution with MAX chip and same FPGA bank:
* less likely to run into obscure Vivado errors, less likely to require mucking around with BUFG chains and timing constraints to fix clock routeability issues, and potentially deal with ensuing in-fabric skew/timing issues.
* less likely to run into Ultrascale instability (may be correctable with Vivado constraints, which I have not explored).
* clock and data in the same bank is the normal Ultrascale I/O configuration, and it is unlikely to hit corner cases, bugs, and other problems.
* one more BoM line
* S/H validation schemes that rely on differential signals cannot be used

Passive solution with resistors and different FPGA bank:
* potential Vivado/Ultrascale problems
* potentially no extra BoM line, easily sourced components
* more possibilities for S/H validation

sbourdeauducq, 2019-03-08:
Maybe add the MAX circuit as an option on the layout and DNP it, then we can solder it on if the Xilinx stuff acts up?

hartytp, 2019-03-08:
@gkasprow I mean using resistors to match the differential LVPECL output to a single-ended STL input at the FPGA. If we did that, I think we could keep all signals within the same bank...

gkasprow, 2019-03-08:
Maybe a simpler option is to route Helper DCXO clock copy to the SDRAM bank.

sbourdeauducq, 2019-03-08:
Then why would we need the original clock?

gkasprow, 2019-03-08:
we need it to get rid of SH violation that would happen when we route the clock between banks.

gkasprow, 2019-03-08:
@I'm not sure we can instantiate single ended SSTL18 together with nearby LVDS in the same bank. It needs checking because Xilinx sometimes has some strange constraint if we want to place single ended STL signals close to other ones.
SSTL needs a reference voltage. I routed Vbias_0.9V to the bank66 VREF.
So if @sbourdeauducq confirms that we can use SSTL18 I will route DDMTD there with modified resistor dividers. It has one drawback. The output voltage from LVPECL has a large variation of the low/high level so it would be hard to make it working with fixed SSTL18 ref level. THat's why I preferred differential signal routing

sbourdeauducq, 2019-03-08:
That doesn't help, it just displaces the problem. You'd have the issue again when crossing the two clock domains.
But AFAICT just moving (completely) the two outputs plus the helper clock to the SDRAM bank should be OK.

gkasprow, 2019-03-08:
At the moment the differential SSTL outputs are routed to the SDRAM bank. I will route the clock as well and this should solve the issue.

sbourdeauducq, 2019-03-08:
OK. @hartytp please confirm that we only need to run the DDMTD edge detector on that clock and then it's just an asynchronous CDC of the counter value to another domain (just like the implementation in jesd204_tools).

hartytp, 2019-03-08:
@sbourdeauducq I'm not sure I follow your question. Normally, one would run the entire WR core from the helper PLL. That includes the helper DCXO frequency lock, the main loop DDMTD, the loop filter, the I2C cores etc.

What's your reason for wanting a CDC? Are you worried about meeting timing in the overall system if it has inputs from the DFF in one FPGA bank and outputs to the I2C core in another bank? If so, wouldn't it be easier to add a few pipe-lining regs than to have a CDC?

sbourdeauducq, 2019-03-08:
> Normally, one would run the entire WR core from the helper PLL. That includes the helper DCXO frequency lock, the main loop DDMTD, the loop filter, the I2C cores etc.

Then any I/Os used by those cores should be in the same bank as the helper PLL clock.

sbourdeauducq, 2019-03-08:
> wouldn't it be easier to add a few pipe-lining regs than to have a CDC?

No.

sbourdeauducq, 2019-03-08:
@gkasprow What are your particular objections to the MAX9172?

WeiDaZhang, 2019-03-08:
If all on helper clk is not realistic, a FIFO could be placed right before the I2C interface, that is when the control signal has been calculated, given an I2C core reacts a FIFO non-empty flag promptly and deterministically in a sense.

sbourdeauducq, 2019-03-08:
All on helper clock is realistic, I'm just trying to minimize Vivado-related frustration here.

hartytp, 2019-03-08:
> I'm just trying to minimize Vivado-related frustration here.

:+1:

I'm happy to do this however you think will be least work. If keeping everything in one bank will make life easier then let's definitely do that.

gkasprow, 2019-03-08:
no objection about the MAX9172 at all. I simply don't like routing single ended clocks across the board.  However, I can try to place these chips very close to the FPGA.

gkasprow, 2019-03-08:
MAX9172 works with 3.3V so still need to convert it to 1.8V.

sbourdeauducq, 2019-03-08:
> However, I can try to place these chips very close to the FPGA.

Sounds good, but why are they across the board? The whole WR circuit is only connected to the FPGA, and AFAICT it makes sense to keep *everything* close to the FPGA.

> MAX9172 works with 3.3V so still need to convert it to 1.8V.

There are probably alternatives - I didn't search very long for this MAX9172.

gkasprow, 2019-03-08:
The LVPECL levels are beyond 1.8V supply so I would have to convert it either to LVDS and then to 1.8V LVCMOS, or to 3.3V LVCMOS and then to 1.8V LVCMOS>
I don't think one can find one chip that does it all.
What's wrong from gateware perspective with using SSTL18 on free IO pins in LVDS bank that WR clocks are delivered already? It is equivalent to using level converters.

gkasprow, 2019-03-08:
We can go for [these](http://www.ti.com/lit/ds/symlink/sn65lvds4.pdf) chips

sbourdeauducq, 2019-03-08:
> What's wrong from gateware perspective with using SSTL18 on free IO pins in LVDS bank that WR clocks are delivered already?

That is fine.

> We can go for [these](http://www.ti.com/lit/ds/symlink/sn65lvds4.pdf) chips

Looks alright - except that their maximum skew variation is not specified...

sbourdeauducq, 2019-03-11:
> I will place DDMTD very close to the oscillators. so there won't be any stubs.

That clock also goes to the FPGA. It needs to be a low-noise clock. In other places, we've been careful about using fanout buffers - is it really OK to connect the helper clock to 3 receivers without buffers?

sbourdeauducq, 2019-03-11:
@hartytp Are CMOS XOs good enough for WR? This is what the schematics says is populated by default.

hartytp, 2019-03-11:
> @hartytp Are CMOS output XOs good enough for WR? This is what the schematics says is populated by default.

IIRC we had a discussion about this on one of the GitHub issues and decided that they were likely to be.

IIRC the LVDS/LVPECL DCXOs were much more expensive/less commonly available, so we wanted to start with the LVCMOS version. We plan to test their performance asap once the new hw arrives. If we find any issues then it's relatively easy to swap them for a different model.

In any case, the LVCMOS DCXO will definitely be good enough for proof-of-principle work, may just have a few dB worse phase noise, which won't be a killer for proto hardware...

gkasprow, 2019-03-11:
So, concerning discussion about DDMTD signals routing. I will leave differential connection to the SDRAM DIFF SSTL15 bank as a backup option and will add single-ended SSTL18 path as a default configuration.
OK?

sbourdeauducq, 2019-03-11:
Ok, sounds good.

hartytp, 2019-03-11:
> will add single-ended SSTL18 path as a default configuration.

Are you sure that single-ended SSTL18 is supported? I guess @sbourdeauducq will check this in his stub port.

gkasprow, 2019-03-11:
Yes, on HP bank the SSTL18 is supported. Please don't use DCI because the signal is already terminated at the source.

sbourdeauducq, 2019-03-21:
Confirmed that Vivado does not complain.

Closed 2019-03-11.

Thread 37 (2019-02-23):

Sayma clocking write up

hartytp, 2019-02-23:
- [ ] post a write up + block diagram of Sayma AMC+RTM clocking

hartytp, 2019-02-23:
@sbourdeauducq @WeiDaZhang if you have any thoughts about the best way of getting the recovered clock out of the RTM (Artix) FPGA and into the DDMTD input then please let me know.

sbourdeauducq, 2019-02-25:
On Artix-7 there is no OBUFDS_GTE3 so we have to go through the fabric (and live with the noise).
The path through BUFMR followed by either BUFIO or BUFR may or may not be lower-noise. Before PCB sign-off we should try a Vivado compilation with this path and the actual proposed pin assignments, and check that it does not complain, so we leave the BUFMR option open in the hardware.

gkasprow, 2019-03-11:
I will ask guys from Creotech to draw something similar as they did for the AFCZ. They will update the documentation anyway.
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

hartytp, 2019-03-11:
Wonderful, thank you! I started, but it's a lot to do and I didn't finish yet.

hartytp, 2019-03-13:
Keeping track of clock signals:
- `AMC_TELECOM_CLOCK`
  - what is this, and what would we use it for?
- `EXT_CLK_IN`
  - diff input via UFLs
  - as an alternate variant, solder jumpers can be used to connect to either telecom clock B or `WR_REF_CLK_IN`
  - goes to GC input in bank 47
  - what is this signal for? AFAICT it's just for debugging
- `WR_REF_CLK_IN`
  - single-ended input (MCX), balun (TCM2-43-X+)
  - goes to bank 66 with other WR signals
  - what is the use-case for this? AFAICT it doesn't go to the front-panel so it's only intended for debugging?
- `REC_CLK_C`
  - recovered clock from the FPGA transceiver (bank 48)
  - clocks the SI5324
  - can also be used as the reference input to the DDMTD DFF by component options/solder jumpers
  - this will be our WR reference clock if we find any issues when using `MGT_CDR_CLK`
- `MGT_CDR_CLK`
  - FPGA transceiver clock output from MGTREFCLK1
  - CML output, which we hope will have extremely low noise (needs testing)
  - clocks the DDMTD DFF
  - our plan A will be to use this as the WR clock
- The recovered clock (main DCXO or Si5324) is buffered and produces the following signals
  - `CLK_CDR_CLEAN0` - goes to a GC pin in bank 66 (NB this can be used for DDMTD if we don't use the external DFFs)
  - `CLK_CDR_CLEAN1` - goes to `MGTREFCLK0` to clock transceivers
  - `CLK_CDR_CLEAN2` - `MGT_REF_CLK0` to clock transceivers
  - `CLK_CDR_CLEAN3` - `MGT_REF_CLK0` to clock transceivers
  - `SDRAM32_CLK` - goes to a GC pin in bank 68 (`DDR_32_CLK`) will we actually use this to clock the SDRAM?
  - `SDRAM64_CLK` - goes to a GC pin in bank 45 (`DDR_64_CLK`) will we actually use this to clock the SDRAM?
  - also available on UFL connectors
- `HELPER_DCXO`
  - the helper oscillator for the WR loop. This is frequency locked at a small offset from the main DCXO to provide a WR frequency of a few kHz to get very low jitter for the phase detector.
- `DDMTD_OUT_CDR_CLK_SSTL18`
  - single-ended output signal from the DDMTD DFF (the transceiver recovered clock sampled by the DDMTD DFF)
  - routed to an input in bank 66 with other WR signals (we don't have enough pins for a diff input!)
  - with different population options, this can be routed as a differential signal to bank 68 as `DDMTD_OUT_CDR_CLK`. We'll try to avoid this to keep all WR signals in the same FPGA bank
- `DDMTD_OUT_Helper_CLK_SSTL18` same as above but for the main WR DCXO
NB @sbourdeauducq the DCXO oscillators are enabled by default so make sure to pull the OE low in gateware when not using them

sbourdeauducq, 2019-03-14:
> * `SDRAM32_CLK` - goes to a GC pin in bank 68 (`DDR_32_CLK`) will we actually use this to clock the SDRAM?
>
> * `SDRAM64_CLK` - goes to a GC pin in bank 45 (`DDR_64_CLK`) will we actually use this to clock the SDRAM?

That's just to make the pinout compatible with the Xilinx core, MiSoC/ARTIQ will not use it.

hartytp, 2019-03-14:
thanks

hartytp, 2019-03-14:
overall plans for AMC clocking:
- assuming we only run Sayma as a DRTIO satellite
- RTIO reference clock comes from master via DRTIO link
- plan A is to use the Si5324 for clock recovery
- plan B is to use WR
- FPGA fabric clock from `CLK_CDR_CLEAN0`
- for WR we use either `MGT_CDR_CLK` or `REC_CLK_C` as the reference clock for the DDMTD
- WR core
@sbourdeauducq I think that covers all the important points for the AMC clocking, right? (Obviously, a BD would still help)

gkasprow, 2019-03-15:
@hartytp
AMC_TELECOM_CLOCK - it is used in MTCA crate to synchronize multiple cards
EXT_CLK_IN - somebody wanted to have the WR clock input also GC-capable. SInce WR_REF goes to another bank where there are no free GC inputs, I routed it also as an option to the bank where GC pair is available.
WR_REF_CLK_IN - can be placed on a front panel.

hartytp, 2019-03-16:
> AMC_TELECOM_CLOCK - it is used in MTCA crate to synchronize multiple cards

Is there any potential use for this in ARTIQ?

hartytp, 2019-03-16:
> WR_REF_CLK_IN - can be placed on a front panel.

If there is space that would be nice. Good to have a high-quality clock capable input on the FP. If not then no problem.

gkasprow, 2019-03-16:
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

not really. These can be essential in the systems where WR receiver that sits on MCH is used to synchronize the AMC boards.

hartytp, 2019-03-16:
On the RTM side, the clocks we have are:
- `GT_CLK0_IN`
  - HMC7043 output routed to AMC. This clocks the AMC JESD204B transceivers
- CDR CLEAN clocks are all copies of the recovered clock from the SI5324/WR DCXO
- `CDR_CLK_CLEAN0` and `EXT_100M_RF_IN`
  - reference clock for the HMC830 and AFE mezzanines (mux selection)
- `CDR_CLK_CLEAN1`
  - goes to RTM FPGA MGTREF. Clocks DRTIO transceivers?
- `CDR_CLK_CLEAN2`
  - goes to MRCC pin on RTM FPGA (bank 34). Main ARTIQ fabric clock for RTM.
- HMC7043 outputs. I'm not clear on which of these are used and how in ARTIQ these days.
- `AMC_FPGA_SYSREF0_P`
- `AMC_FPGA_SYSREF0_P`
- `RTM_FPGA_SYSREF0`
- `RTM_FPGA_SYSREF1`

Also, why is is `REC_CLK_C` not just `REC_CLK`?

gkasprow, 2019-03-16:
> Also, why is is REC_CLK_C not just REC_CLK?
_C means that it is the same signal but after the coupling capacitors.

hartytp, 2019-03-16:
aah, okay, thanks for clarifying

sbourdeauducq, 2019-03-21:
> `MGT_CDR_CLK`
>
>     * clocks the DDMTD DFF

It does't clock it. It is sampled by it. The FFs are clocked by the helper oscillator.

Closed 2019-09-30.

Thread 38 (2019-02-25):

purpose of USB console switch

sbourdeauducq, 2019-02-25:
What is the purpose of the "USB console switch" IC4?

gkasprow, 2019-02-25:
well, it made sence when MMC had access to Ethernet.
Now we can scrap it.
In AFCZ we found it very useful when operating in the singe-AMC box but MMC has Ethernet access and we can run UART over IP.

Closed 2019-02-25.

Thread 39 (2019-02-25):

Ethernet PHY programming

sbourdeauducq, 2019-02-25:
I wonder if it is really necessary to allow connecting the PHY MDIO (as well as MODE and RESET) to the MMC. The FPGA should be able to program it and handle MODE/RESET, and the MMC does not need Ethernet.

gkasprow, 2019-02-25:
true, the PHY needs switching from 1000base-T to 1000base-x mode by setting one bit. By default it talks to the RJ45 connector. For diagnostic purposes, I added pin header for such a connector.
If you can handle this, I can scrap the mux.

sbourdeauducq, 2019-02-26:
Yes, scrap the mux. What register(s) should be written exactly?

sbourdeauducq, 2019-02-27:
In https://github.com/jbqubit/saymapp/blob/master/pp.md#ethernet
"Configuration of M88E1512 is by static pin strapping: 1 Gbps, GMII, 1000BASE-X."
Is that incorrect?

gkasprow, 2019-02-27:
not really. Look [here](https://www.marvell.com/documents/eoxwrbluvwybgxvagkkf/) p39
One needs to set one bit in register
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
That's why I wanted to do it via MMC so you don't have to talk to the PHY.

sbourdeauducq, 2019-02-27:
Doing it in the FPGA is certainly easier and less frustrating.

gkasprow, 2019-02-27:
OK, so let's scrap the mux and close it.

gkasprow, 2019-02-27:
do you need the PHY reset to be routed to the FPGA?

gkasprow, 2019-02-27:
and what about the INT?

sbourdeauducq, 2019-02-27:
I need the PHY reset (always useful to recover from problems), INT is not necessary but can be routed if easy.

gkasprow, 2019-02-27:
OK, managed to connect both.

Closed 2019-02-27.

Thread 40 (2019-02-25):

signal names on AMC for programming RTM FPGA

sbourdeauducq, 2019-02-25:
The signal names in the .txt files do not look good, e.g. for CCLK:
```
\$6N9201\  \R308\-\1\ \IC37\-\J25\
```
Is this just because of the series resistors/jumpers e.g. R308?
What is the purpose of those resistors? What about using test points instead?

gkasprow, 2019-02-25:
These resistors are assembly options. It is still possible to chain both FPGAs and load from the same FLASH...
I added nets with _R
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

Closed 2019-02-25.

Thread 41 (2019-02-25):

REC_CLOCK_P/N "NOT USED"?

sbourdeauducq, 2019-02-25:
Why is this signal marked as "NOT USED" on the schematics? It is a crucial signal for DRTIO with the Si5324.

sbourdeauducq, 2019-02-25:
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

gkasprow, 2019-02-25:
true.
Please use Altium schematics for any new issues. I did a lot of cleaning while porting to Altium.
I added it to release
https://github.com/sinara-hw/Sayma_AMC/releases/tag/v2.0rc2

Closed 2019-02-25.

Thread 45 (2019-02-25):

supplying VCCBRAM with VCCINT from same rail

gkasprow, 2019-02-25:
* [ ]  P0V9 should be probably renamed to P0V95 (but net P0V95 already exists, could it be merged? VCCBRAM seems to have low current draw, at least 31 mA is noted on schematics)

Any objection to connecting VCCBRAM with VCCINT?

gkasprow, 2019-03-06:
let's keep it as it is now. I added 0R option so we can test it.

gkasprow, 2019-03-06:
DS says: If VCCINT/VCCINT_IO and VCCBRAM have the same recommended voltage levels, they can be powered by the same supply and ramped simultaneously.  So let's connect them together with 0R

Closed 2019-03-06.

Thread 49 (2019-02-27):

DNP FPGA daisy chain configuration loading resistors R200-R227

jordens, 2019-02-27:
DNP by default. We currently don't use daisy chain loading but slave serial via AMC FPGA bank 65.

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

These were R176-R180 on Sayma AMC v1.0

gkasprow, 2019-02-27:
true, fixed

Closed 2019-02-27.

Thread 50 (2019-02-28):

DNP ALT_PORT0 jumpers

jordens, 2019-02-28:
Depending on how you do the routing, you'll probably want to DNP C182-C185.

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

gkasprow, 2019-03-05:
done

sbourdeauducq, 2019-04-10:
GTH Ethernet is working on Sayma v1 now, and we'll probably want to use that (no need to configure the PHY chip and no issues with RGMII timing) - so it's the capacitors for the other path (with the PHY chip) that should be DNP'd.

sbourdeauducq, 2019-04-10:
Do not remove the PHY chip though, just in case there are unforeseen transceiver problems.

gkasprow, 2019-04-27:
@sbourdeauducq in such case we will loose one SFP. Maybe it should be not mounted?

sbourdeauducq, 2019-04-28:
OK.

Closed 2019-05-20.

Thread 51 (2019-02-28):

JTAG chain ordering

jordens, 2019-02-28:
Make sure the ordering of the JTAG TAPs is the same as with the JTAG switch on Sayma v1.
IIRC on Sayma v1, the RTM FPGA was "last" (which means "closest to TDO" and "tap0 in openocd").

jordens, 2019-02-28:
checked schematics. looks correct.

Closed 2019-02-28.

Thread 52 (2019-03-03):

GC pins SMA/I2C/WR_REF

jordens, 2019-03-03:
* Does the I2C interface to the oscillators really need GC pins? If not (and I'd hope that the I2C cores don't), I'd suggest swapping the SMA_IO lines and the various I2C signals so that the SMA_IOs are on GC pins.
* Also the WR_REF_CLK_IN is on a non-GC pin currently. That prevents if from being used for anything other than WR-style phase detection. It would not be usable for general clocking purposes during boot strapping, characterization, or other ideas. May be fine, but needs explicit ack and a schematic note IMO. ~~Alternatively sacrifice a LVDS CC pair.~~

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

gkasprow, 2019-03-05:
I can route it to neighboring bank 47 I have there one free GC pair. @hartytp ack please

gkasprow, 2019-03-05:
Anyway if we want to use ext WR clock, shouldn't we deliver it to external DDMTD as well?

hartytp, 2019-03-06:
>  Does the I2C interface to the oscillators really need GC pins? If  not (and I'd hope that the I2C cores don't), I'd suggest swapping the  SMA_IO lines and the various I2C signals so that the SMA_IOs are on GC  pins.

No. It's only a 1MHz interface, so I don't expect any issues here.

jordens, 2019-03-06:
Speed is not the question. Whether or not you clock logic from SDA/SCL is. If you don't oversample, you'll have to.

WeiDaZhang, 2019-03-06:
The implementation of I2C we are using is oversampled, and the SCL/SDA are act as normal 'inout' rather than clock.
https://github.com/ktemkin/VHDL-light-sensors/blob/master/i2c_master.vhd
So,
> Does the I2C interface to the oscillators really need GC pins? If not (and I'd hope that the I2C cores don't), I'd suggest swapping the SMA_IO lines and the various I2C signals so that the SMA_IOs are on GC pins.

No. @jordens

We ran it in our imploementation of WR on KC705, where the I2C pins are not on GC/CC/SRCC/MRCC neither.
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

hartytp, 2019-03-06:
> https://github.com/ktemkin/VHDL-light-sensors/blob/master/i2c_master.vhd

We'll probably want to switch to the [misoc](https://github.com/m-labs/misoc/blob/master/misoc/cores/i2c.py) core for the ARTIQ implementation however.

marmeladapk, 2019-03-06:
@hartytp This misoc core doesn't work. I spent some time in Creotech fixing it, I could sent PR sometime in the future.

hartytp, 2019-03-06:
Good to know! I’m sure bug fixes would be welcome.

gkasprow, 2019-03-06:
The I2C pins were connected to the GC pins by pure coincidence. I did not plan to clock the FPGA fabric using I2C clock :)

gkasprow, 2019-03-06:
I can make assembly options and route WR clock to either IO pins in WR bank or GC in another bank so it can be used as a clock input.

gkasprow, 2019-03-06:
done, closing

Closed 2019-03-06.

Thread 53 (2019-03-03):

transmission line transformers compensation caps, capacitor jumpers, TCKC

jordens, 2019-03-03:
On the RTM:

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

But on the AMC:

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

* Add the 0.5 pF compensation caps as well.
* Mark C272/C270 DNP

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

* Also remove the TCKC_B_N/TCKC_B_P net labels. AFAICT they are wrong/confusing.

gkasprow, 2019-03-05:
done
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

Closed 2019-03-05.

Thread 57 (2019-03-11):

git tag

sbourdeauducq, 2019-03-11:
The git tag for v2.0rc4 should be "v2.0rc4" and not "v20rc4".
The git documentation explains how to remove tags.

gkasprow, 2019-03-11:
I changed it in releases. Is it sufficient?

sbourdeauducq, 2019-03-11:
No: https://github.com/sinara-hw/Sayma_AMC/releases
You need to make note of the commit ID (e4bb4899cf2f2b5a73dc6fdeb7a25576b612e0c5), delete the tag from both GitHub and your local copy, create it again at the correct commit, and push it again.
If you have not done this before, I suggest making a full backup of the repository before doing it, in case you break something.

Closed 2019-03-11.

Thread 58 (2019-03-11):

serwb signals?

sbourdeauducq, 2019-03-11:
On v2.0rc4, the signals used for serwb (e.g. ``rtm_fpga_lvds1_p``) are simply called e.g. ``lvds2``.
Are we sure that they will go to the correct pins on the RTM FPGA?
In particular the clock pins (currently J8/H8 - LVDS11 on the AMC side) must go to a clock-capable input on the RTM FPGA.

It is particularly important that serwb works correctly as @jbqubit refuses to fund a migration to pure DRTIO.

sbourdeauducq, 2019-03-11:
Similary, what used to be a HMC7043 SYSREF signal going to the FPGA is now "LVDS10" (unless I'm mistaken).
This is an important signal (for DAC synchronization) so it must be connected correctly. It does not need to be on a GC pin.

hartytp, 2019-03-11:
> It is particularly important that serwb works correctly as @jbqubit refuses to fund a migration to pure DRTIO.

I'm not sure that's entirely the most constructive way of making your point here.

hartytp, 2019-03-11:
> On v2.0rc4, the signals used for serwb (e.g. rtm_fpga_lvds1_p) are simply called e.g. lvds2.

Yes, that is a change that we discussed on GitHub some time ago. The rationale was that in v1.0 we found that the usage of some of these lines changed after the schematics were frozen. It was confusing to have a mismatch between the schematic and code. So, seems better to avoid encoding functionality into the signal names in these cases.

> This is an important signal (for DAC synchronization) so it must be connected correctly. It does not need to be on a GC pin.

Can you be more specific? What are the requirements for this signal?

> In particular the clock pins (currently J8/H8 - LVDS11 on the AMC side) must go to a clock-capable input on the RTM FPGA.

Is that the only requirement for this signal?

sbourdeauducq, 2019-03-11:
> > This is an important signal (for DAC synchronization) so it must be connected correctly. It does not need to be on a GC pin.
>
> Can you be more specific? What are the requirements for this signal?

With the current synchronization scheme, that signal goes to an ISERDES input that is clocked by the GTH, and there are no particular requirements.

> > In particular the clock pins (currently J8/H8 - LVDS11 on the AMC side) must go to a clock-capable input on the RTM FPGA.
>
> Is that the only requirement for this signal?

Yes.
If we use generic names then maybe we can use "CC_RTM" in the name (similar to what FMC does) to indicate that the signal goes to a CC pin on the RTM side.
I think there still should be a difference in names between signals that are intended for the RTM FPGA and those intended for mezzanines.

hartytp, 2019-03-11:
> I think there still should be a difference in names between signals that are intended for the RTM FPGA and those intended for mezzanines.

I don't feel strongly about this. However, I believe we previously agreed not to do that on the grounds that we might end up using Sayma AMC v2.0 with something other than Sayma RTM v2.0, so best to keep all signal names generic from the AMC POV.

Adding _cc for lines that go to a CC pin on the AMC side does sound like a good idea.

gkasprow, 2019-03-11:
The clock capable signals are called _CC on both AMC and RTM side.
You have 3 LVDS pairs that connect both FPGAs.
LVDS25, 26 and 27
LVDS26_CC is routed to GC pins on AMC side (1V8 bank) and MRCC on RTM side (2V5 bank)
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

gkasprow, 2019-03-11:
I've just changed their direction to bidir.

gkasprow, 2019-03-11:
Now there are 4 SYSREF signals connected. Two go to AMC FPGA LVDS21(bank47) and LVDS30(bank66)
Another two go to RTM FPGA SRCC and IO pins

sbourdeauducq, 2019-03-11:
Okay, good!

sbourdeauducq, 2019-03-11:
> Another two go to RTM FPGA SRCC and IO pins

FYI, there is no current requirement to connect SYSREF to CC pins anywhere. But it can't hurt, and we might want extra clocking path if something unexpected happens...

Closed 2019-03-11.

Thread 59 (2019-03-11):

connect DDMTD input to quad 224

sbourdeauducq, 2019-03-11:
Quad 224 is where DRTIO CDR is happening, and the output from this quad may be more precise than after it has gone through more FPGA routing to reach quad 225 where MGT_CDR_CLK is currently connected.
OBUFDS_GTE3 may be even unable to obtain clocks from adjacent quads (see Figure 2-3 in ug576: I don't see a path from other quads).

I suggest swapping MGT_CDR_CLK and FCLKAC_N - Ethernet clocking will be fine with one quad crossed, and I have no use for the AMC fabric clock.

gkasprow, 2019-03-11:
done
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

Closed 2019-03-11.

Thread 62 (2019-03-13):

schematics cosmetics

hartytp, 2019-03-13:
- [x] The annotation "100MHz clock output to Sayma_RTM Impedance: 50Ohm" is not correct (this won't be 100MHz and normally won't be used to clock the RTM). Better to annotate with something like "CDR/WR clock output"

hartytp, 2019-03-13:
The new Altium schematics look lovely thought!

hartytp, 2019-03-13:
- [ ] p23 is mislabelled. It says "FPGA bank 65 (RTM LVDS)" but it has bank 66 in it

hartytp, 2019-03-13:
There are a few places where it might help to label the expected signal levels (e.g. for clock inputs, or which logic standards should be used on the FPGA pins).

hartytp, 2019-03-13:
- [ ]  "so no need matching" should be "so no matching needed" or "so don't need matching"

hartytp, 2019-03-13:
- [ ] nit pick Small inconsistency between the AMC and RTM: 'FPGA_CFG_PROGRAM_B' v 'FPGA_CFG_PROG_B'

Closed 2019-03-25.

Thread 63 (2019-03-13):

consider making all UFLs MMCX

hartytp, 2019-03-13:
It would be easier if I didn't have to stock two types of cable. If there are layout/mechanical reasons why this isn't easy for all connectors then it's fine to leave things how they are.

sbourdeauducq, 2019-03-22:
uFLs are lower-profile and make jumper cables slightly easier to use e.g. if the board has to be put into the uTCA chassis with additional jumper cables installed (as is necessary now for DAC synch on v1).

sbourdeauducq, 2019-03-22:
For example, it still fits in the uTCA crate with uFL jumper cables on the bottom side of the boards.

gkasprow, 2019-03-25:
I placed all uFL connectors on the bottom of the board because of clock distribution circuits resites there

Closed 2019-03-25.

Thread 64 (2019-03-13):

DNP WR LVPECL bias resistors

hartytp, 2019-03-13:
R378 and R363 should be DNP by default since we use LVCMOS DCXOs

hartytp, 2019-03-13:
Also shouldn't R375 be populated? (Is this supposed to be a capacitor to ground, or a 0R resistor?)

hartytp, 2019-03-13:
In fact, generally, please can someone double check the LVCMOS to LVDS conversion at the helper DCXO output. Thanks!

jbqubit, 2019-03-15:
@marmeladapk Can you do this?

gkasprow, 2019-03-25:
@hartytp I think it is fine.
The CMOS oscillator generates too high voltage for LVDS input. That's why we need R377 and R378 assembled. R363 is also part of it.

Closed 2019-03-25.

Thread 65 (2019-03-13):

DFF decoupling

hartytp, 2019-03-13:
Is it worth sticking 100nF at each VBB/VCC pin on the DFF instead of one for the whole package?

hartytp, 2019-03-13:
I won't check the LVPECL to SSTL conversion, but please do make sure you're happy with it and that we get a decent signal at the FPGA.

gkasprow, 2019-03-25:
There is one VBB pin. AD library instantiates it twice. The same applies to VCC pins that normally are hidden but AD19 do not really support hidden supply pins so I had to enable them and connect to desired power net. So treat it as a temporary solution, all CERN libraries would have to be modified to support AD19.
The DIFF SSTL clock entry would work fine.  The SSTL18 single-ended clock entry does not have such high margin but should work. Diff SSTL15 requires 100mV of clock amplitude while SSTL18 requires 125mV and we are driving it single ended and are on the edge of the specification in extreme temperature cases.

Closed 2019-03-25.

Thread 67 (2019-03-13):

layout fixes

gkasprow, 2019-03-13:
added issue to make sure we don't forget about:

 - [x] label all important ICs on the silk
 - [x] add test points to all power rails, slow busses (I2C/SPI) and other important signals. where possible also aim to expose all clocks via ufl or similar (e.g. if there is an unused output on a clock buffer then connect it to a UFL test point)
 - [x] for slow signals, don't make traces + vias unneccesarily small and don't cram components too close together (obviously, feel free to ignore this where it makes a genuine difference to SI/ease of layout, but don't just cram things together where they don't need to be)
 - [x] where possible (particularly slow signals) add 0R resistors that can be used to disconnect the signal and allow injection of an external signal. also consider adding 0R/DNP pull-ups/pull-downs on logic lines
 - [x] make sure that there is some accessible (e.g. by scratching off solder mask) ground/grounded test-points scattered on the top and bottom side
etc. Just standard good practice. This kind of thing makes debugging the EEMs much easier than debugging Sayma

Closed 2019-04-07.

Thread 68 (2019-03-18):

Sayma buck converter

gkasprow, 2019-03-18:
I want to kick out the Exar option completely, not only DNP. It messes up with the layout.
I have a bunch of tiny modules I developed for another project, roughly 2x2x1cm with Exar 7724 chip on it. I will just add mounting holes for these modules as a backup option.

jbqubit, 2019-03-19:
Please clarify what you mean. You're kicking out Exar but then using Exar 7724 on module? What's the role of what's soldered on the board vs the modules you're proposing?

hartytp, 2019-03-19:
> Please clarify what you mean. You're kicking out Exar but then using Exar 7724 on module?

I believe that what he means is that he's kicking the Exar out completely. But, as a risk mitigation strategy, adding some pads so that we could add a small board with a different regulator (such as the Exar chip). It's just paranoia to cover the (hopefully unlikely) scenario that the new regulator works less well than the old exar.

gkasprow, 2019-03-19:
Exactly. Just risk mitigation. I didn't have any issues with these Exar7724 modules so will leave it as an option in case we have issues with the module.

gkasprow, 2019-03-25:
I added a few mounting holes for the module. Below I fitted several components so no PCB real estate is wasted by DNPs
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

Closed 2019-03-25.

Thread 70 (2019-03-21):

"Si5325" typo

sbourdeauducq, 2019-03-21:
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

sbourdeauducq, 2019-03-21:
Also, why is that a "WR clock input"? What are the exact use cases for this connector and signal?

hartytp, 2019-03-21:
@sbourdeauducq It's not really a WR clock input at all. IIRC, it's just an unbuffered connector that goes to a GC pin.

The main use WR case I can think of for WR would be the reference clock if Sayma were used as the master. However, I suspect that it will be useful for testing and debugging the WR implementation. But, I would support a better name for the signal.

sbourdeauducq, 2019-03-22:
Let's just call it "AMC external clock input".

Closed 2019-03-25.

Thread 71 (2019-03-21):

32-bit DDR DQS P/N swapped

sbourdeauducq, 2019-03-21:
The DQS_P signals go on the N side of the I/O buffers, and vice versa.
Was this done to ease board routing?
If really necessary, we can deal with it with the MiSoC controller, but it makes things a bit unusual and I don't know if the Xilinx cores (and others) will be happy with that.

gkasprow, 2019-03-21:
It happened probably during design migration. Good catch!
I will run SDRAM simulator anyway after I finish routing.

marmeladapk, 2019-03-22:
@gkasprow @sbourdeauducq Whole IC37I is swapped upside down (mirrored along X axis). This is the real issue here. This also means that VRP signal is not connected where it should be.

gkasprow, 2019-03-22:
OK, I'll fix it.

gkasprow, 2019-03-22:
I'm a bit surprised that with mirrored connections the stub port did not generate serious issues.
DDR3 controller uses DQS pins in a quite restricted way.

sbourdeauducq, 2019-03-23:
> DDR3 controller uses DQS pins in a quite restricted way.

In MiSoC, we're not using the "native mode I/O" where most of the DQS restrictions come from.

> I will run SDRAM simulator anyway after I finish routing.

Does that include trying to compile a design with the Xilinx SDRAM core?

gkasprow, 2019-03-24:
OK, fixed.
I did not touch traces that were routed in rev1. And noticed that Altium had problems with proper sync between sch and pcb. With fixed schematic the problems disapperared.
I will redo verification with Hyperlynx SiDDR tool. It check SI and crosstalk only, it's verilog model does not take into account Xilinx IP.

Closed 2019-03-25.

Thread 74 (2019-03-22):

Disable pin swapping by changing schematic pins in project preferences

marmeladapk, 2019-03-22:

Closed 2019-03-25.

Thread 75 (2019-03-25):

Sayma AMC panel

gkasprow, 2019-03-25:
I managed to place 4 MCX connectors with reasonable spacing. But one won't be able to use MCX-SMA adapters directly, only cables.
I used dual SFP cage instead of 2 single ones.

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

Closed 2019-04-07.

Thread 76 (2019-03-29):

I2C address map

marmeladapk, 2019-03-29:
- Mux port 0: does each FMC have those two chips listed? They are not placed on Sayma
- remove note on the left in I@C_MUX schematics, it has information from older boards
- add a note on mux port 5, that XR77 is only present when module with it is inserted?
- in Thermomenters note that IC49 has 0x51 address for EEPROM and 0x59 for EUI access (read only)? Though it is noted on I2C_MUX table
- LM75 on mux port 7 has 0x4f instead of 0x4a address
- on RTM ports (table on the right): mux port 0 and 2 are analog mezzanine 0 and 1 (or 1 and 2, depending on how you count) and basemods currently have only EEPROM and ADT chips (address: 0x48)
- rtm mux port 1, 3 and 4 are empty- RTM still has XR chip, will it be removed as well?

gkasprow, 2019-04-07:
Mux port 0 assumes FMC module plugged with the chips.
I assumed chip present also on TestMod boards where I2C extenders are installed
each mezzanine has 2x I2C buses.

Closed 2019-04-07.

Thread 78 (2019-03-29):

Invalid IC44/~CLK0 termination

kaolpr, 2019-03-29:
In default variant IC44/CLK0 is single-ended. According to [datasheet](https://www.analog.com/media/en/technical-documentation/data-sheets/ADCLK948.pdf) single-ended AC coupled input should be connected like that:
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
however unused ~CLK0 is only connected to ground via 100 nF capacitor.

gkasprow, 2019-04-07:
they are equivalent from the signal point of view. 100nF capacitor makes a short circuit for RF frequencies.

Closed 2019-04-07.

Thread 79 (2019-03-29):

DRC rules & DRC (schematics)

marmeladapk, 2019-03-29:
- Power pin connected to output should generate at most a warning (most bucks and LDO's have voltage output marked as an output pin, not as a power pin)
- Output pin and bidirectional sheet entry (and port) shouldn't create an error (output pin and bidirectional pin don't create errors)
- generally I feel that output or input object shouldn't create an error with bidirectional object

Small issues found:
- LTM_PGOOD port on QUAD_BUCK schematic should be an output port
- PGOOD port on SDRAM_DDR3_2x16 should be an output
- T29B should probably be shown on schematic with all pins NCd

All other errors (and one fatal error) should be suppressed using NO ERC mark which targets a specific DRC.

I looked through most of other warnings. Multiple net names could probably be resolved one day, I managed to do this somehow on Kasli, but it requires a lot of experimentation, not worth it right now.

The goal is to have no error during compilation.

gkasprow, 2019-04-26:
if we make PGOOD output port, Altium won't like it either.

gkasprow, 2019-05-20:
I want to leave the warnings. If we place "no ERC" and if there is some issue on that line, it won't find it.

Closed 2019-05-20.

Thread 82 (2019-03-29):

Helper_CLK variant connections

kaolpr, 2019-03-29:
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

- What is a point of having R375? In what case it should be mounted?
- It looks like distance between current location of R386 and J33 may result in having a stub. Should R386 be mounted by default?

gkasprow, 2019-04-07:
with R375 we increase the signal amplitude

Closed 2019-04-07.

Thread 83 (2019-03-29):

Graphics in schematics

kaolpr, 2019-03-29:
Graphics placed in schematics are linked to local content and can not be opened.

marmeladapk, 2019-03-29:
This includes ARTIQ logo that is placed in template.

gkasprow, 2019-04-07:
fixed. Images are referenced locally.

Closed 2019-04-07.

Thread 85 (2019-03-29):

R389 not needed

kaolpr, 2019-03-29:
R389 is not needed as its not mounted in default variant and connection can be done with SW2 switch.

gkasprow, 2019-04-07:
true, but it can be useful in some cases. Let's leave it DNP by default.

Closed 2019-04-07.

Thread 90 (2019-04-01):

LTM4644 review

marmeladapk, 2019-04-01:
- change undefined resistors to 10pF DNPed capacitors and add a note about their purpose. Right now it looks like voltage divider.
- Why is SVIN connected to P5V0 instead of P12V0?

Symbol pins were checked against DS.

gkasprow, 2019-04-07:
undefined resistors are to support LTM4644A chip in case of issues with availability. The only difference is the lack of internal feedback resistors. I added a note.
We use 5V VIN to improve efficiency.

Closed 2019-04-07.

Thread 92 (2019-04-08):

Testpoints

marmeladapk, 2019-04-08:
- SDA testpoint has silkscreen in pad
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
- LTM4644 has unlabeled testpoints
- Many testpoints do not have names of signals, only e.g "TP4" is written
- TP15, TP14 are under front panel

gkasprow, 2019-05-20:
can't move TP15,TP16 away without breaking SI. Other issues were fixed

Closed 2019-05-20.

Thread 93 (2019-04-12):

IC2 (LPC "optional" memory) use case

kaolpr, 2019-04-12:
Do we still need IC2 (MT25QL256ABA8ESF-0AAT)? It is currently mounted by default.

I guess it originates from the times when LPC had Ethernet connection to enable easy updates of gateware. However now, when LPC is not connected to port 0 anymore, remote update would have to be done using I2C what sounds like a bit of pain...

Additionally IC2 draws up to 35 mA of precious 3V3MP (limit for AMC+RTM is 180 mA).

gkasprow, 2019-04-12:
we do not have a use case for it so can make it DNP

Closed 2019-04-27.

Thread 94 (2019-04-12):

No fiducial targets

marmeladapk, 2019-04-12:
On both sides

marmeladapk, 2019-04-15:
(or if these pads are fiducial targets then this pad is probably too close to chip)
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

gkasprow, 2019-04-27:
they are Xpedition leftovers. I added right ones to the schematics.

Closed 2019-04-27.

Thread 95 (2019-04-12):

No stackup table in gerber files

marmeladapk, 2019-04-12:
Stackup should probably be on L1.

gkasprow, 2019-04-28:
added to Drill Drawing layer to not cause DRC errors on L1.

Closed 2019-04-28.

Thread 99 (2019-04-12):

3V3MP power budget

kaolpr, 2019-04-12:
I've noticed some issues regarding 3V3MP power budget:

* missing IC2 (MT25QL256ABA8ESF) memory (35 mA),
* missing IC5 (SN74CB3T3257PW + load) JTAG buffer (5 mA),
* N25Q256A13ESF40 2x should be MT25QL256ABA8ESF and it is not MP (-20 mA),
* TCA9548 x2 will not draw 100 mA, I guess it was supposed to be 100 uA.

After having fixed above, sum of 3V3MP current is 316 mA, whereas mTCA specification states that AMC should draw no more than 150 mA alone and 180 mA with RTM connected.

To solve this issue we can:

* remove IC2 (#93),
* connect IC5 to P3V3.

Then budget for MMC is ~120 mA what should be taken into account when developing MMC firmware.

gkasprow, 2019-05-20:
IC2 is DNP
IC5 must be connected to RTM power
ARM power consumption was placed with large margin. We won't consume 200mA for sure.

Closed 2019-05-20.

Thread 101 (2019-04-15):

DDR32_VREF is very thin

marmeladapk, 2019-04-15:
0,076 mm, could be easily made thicker as there's a lot of space on bottom layer near it.

gkasprow, 2019-04-27:
changed to 0.22mm

Closed 2019-04-27.

Thread 103 (2019-04-15):

Decoupling issues

marmeladapk, 2019-04-15:
- [x] 4 capacitors share the same via to the ground

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

- [x] There is no decoupling capacitor near IC54 (C404 is found far away)
- [x] IC56 has no decoupling (C521 is far away)
- [x] C445 should probably be closer to IC29
- [x] IC30B doesn't have decoupling (its decoupling capacitor is near IC30A)
- [x] IC12 doesn't have dedicated decoupling
- [x] IC9 doesn't have P3V3 decoupled
- [x] C402 could be on the same side as IC52
- [x] LPC decoupling is a bit of a mess
- [x] Move L15 here? (and similarly with OSC1)

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

- [x] Fix OSC4 & 5 decoupling

Closed 2019-04-27.

Thread 104 (2019-04-15):

Autorouter madness

marmeladapk, 2019-04-15:
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

marmeladapk, 2019-04-15:
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

marmeladapk, 2019-04-15:
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
Shared via

marmeladapk, 2019-04-15:
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

marmeladapk, 2019-04-15:
IC32A

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

marmeladapk, 2019-04-15:
Near IC21

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

marmeladapk, 2019-04-15:
Near C441
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

marmeladapk, 2019-04-15:
General remark: more vias to ground for caps on the right of the FPGA?

marmeladapk, 2019-04-15:
Q1

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

marmeladapk, 2019-04-15:
Si5324 could use moure grounding vias

marmeladapk, 2019-04-15:
C102
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

marmeladapk, 2019-04-15:
3 capacitors share the same ground via near C355

marmeladapk, 2019-04-15:
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

Not needed wobbles

gkasprow, 2019-04-27:
some loops are intentional. The first one is to protect traces agaisnt ESD discharge.

Closed 2019-04-27.

Thread 106 (2019-04-15):

SDRAM termination

marmeladapk, 2019-04-15:
DDR3_32_A10 and A13 terminating resistors should be behind sdram pin

gkasprow, 2019-04-27:
good catch!. fixed

Closed 2019-04-27.

Thread 107 (2019-04-15):

Current shortage on 3V3P

kaolpr, 2019-04-15:
In worst case scenario, when DDR termination draws maximum current and FMC draws maximum current allowed by FMC specification, MLVDS are used as well as both SFP we may have a severe overcurrent on 3V3 rail.

Budget assumes 4A and in such situation about 5.8A can be drawn (**worst** case). After quick chat with @gkasprow the following solution is proposed:
* state that card is not fully FMC-compliant and 3V3 current shall not exceed 2A,
* move SFP to P5V0 rail (adding buck converter).

Above steps will make worst case load slightly less than 4A.

gkasprow, 2019-04-27:
Let's add individual 3A buck for FMC 3V3.
NCP3710A which we already use would be fine.

Closed 2019-04-27.

Thread 110 (2019-04-15):

Different vias are used for mgt signals

marmeladapk, 2019-04-15:
E.g. for SFP1TX 01 03 vias are used and for ATX0 02 041 vias are used.

Which one should be used? Are they impedance controlled or is there no practical difference?

gkasprow, 2019-04-28:
fixed.
via impedance are as critical as trace impedance. This will be verified with Hyperlynx.

Closed 2019-04-28.

Thread 111 (2019-04-15):

P3V3_CLK sequencing

kaolpr, 2019-04-15:
Connect EN pin of IC1 to MMC. It will allow full control over power supply sequence. Now P5V0 must be present prior to 1V, 1V5, 1V8 and 3V3 what means that P3V3 is also present prior to those voltages.

gkasprow, 2019-04-27:
added

Closed 2019-04-27.

Thread 113 (2019-04-16):

Power budget (AMC+RTM)

kaolpr, 2019-04-16:
There seems to be an issue with mTCA compliance regarding total power on AMC and RTM. AMC and RTM may require up to 45W and 95-100W, respectively. It sums up to 140-145W, whereas mTCA specification states that:

- The average power on the uRTM **shall not** exceed 30 W.
- The maximum power available to the AMC/RTM combination is 80W.

gkasprow, 2019-05-20:
The power consumption estimation was under the assumption that we fully load all AFE rails, FMC rails and run all FPGA with full speed.  Currently, the full set of AMC + RTM + AFEs consumes roughly 40..50W of power. So we still have 30..40W of margin.

marmeladapk, 2019-07-16:
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

🤔

Either way, 4,5A on 1V5 is still concerning, since LTM4644 can output 4 A.

Found by @tprzywoz

gkasprow, 2019-07-24:
Well, this value was assumed with a large margin, taken from max power the memory can dissipate.

Closed 2019-05-20.

Thread 114 (2019-04-28):

Sayma AMC PI verification

gkasprow, 2019-04-28:
VCCINT after optimization. The VCCINT is measured and stabilized under the FPGA, but I made sure the drop is the lowest possible. Ivccint = 10A
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

gkasprow, 2019-04-29:
P3V3 rail
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

gkasprow, 2019-04-29:
P1V8 rail
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

gkasprow, 2019-04-29:
P1V5 after heavy optimization
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

gkasprow, 2019-04-29:
P1V2
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

gkasprow, 2019-04-30:
P12V0 after heavy optimization. I managed to reduce losses twice.
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
we cannot do much with power density  because it is dominated by the power pins in the AMC connector
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

Closed 2019-05-11.

Thread 115 (2019-05-02):

Sayma AMC SI verification

gkasprow, 2019-05-02:
Results of DDR verification
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

gkasprow, 2019-05-02:
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

gkasprow, 2019-05-02:
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

gkasprow, 2019-05-02:
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

gkasprow, 2019-05-03:
The whole simulation including crosstalks and FR4 losses takes roughly 12hours on quad Xeon machine. Now I'm simulating DDR32 memory.

gkasprow, 2019-05-03:
@sbourdeauducq I'm doing simulations for 800MT/s (400MHz clock) Is that sufficient?

gkasprow, 2019-05-03:
DDR32 results
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

sbourdeauducq, 2019-05-04:
>  I'm doing simulations for 800MT/s (400MHz clock) Is that sufficient?

The current ARTIQ/MiSoC does 1000MT/s (and we might want to crank that up in the future).

gkasprow, 2019-05-04:
OK, so I will optimize it for 1066MT/s

Closed 2019-05-20.

Thread 118 (2019-05-06):

Beef up 5V USB to 3.3V LDO

marmeladapk, 2019-05-06:
https://github.com/sinara-hw/Kasli/issues/24

Closed 2019-05-11.

Thread 119 (2019-05-06):

DRC (PCB)

marmeladapk, 2019-05-06:
Fix remaining errors (I have around 260) from DRC. Also make sure to repour polygons before pushing new files to repository.

marmeladapk, 2019-05-14:
@tprzywoz noticed that clearance rules are in the wrong order and supersede theoretically more specific rules (e.g. diff2diff).

gkasprow, 2019-05-20:
That's OK with priorities. diff2others is disabled. I used it only for routing.

Closed 2019-05-20.

Thread 120 (2019-08-14):

P0V95 diode isn't connected to P0V95 rail

marmeladapk, 2019-08-14:
I just noticed that there are P0V95B and P0V95I rails in the project and diode is connected to P0V95.

marmeladapk, 2019-08-14:
Also testpoint is connected to P0V95 net.

Thread 122 (2019-09-09):

HT3 manufacturing, baseline testing

jbqubit, 2019-09-09:
HT3 is hardware testing phase that is conducted by the hardware vendor. Details are discussed in the [Sayma v2 hardware contract](Sayma-v2-contracts).  TS2 and TS7 refer to crate configurations detailed [here](Sayma-v2-contracts).

Create independent Issues to track tests and report observations as appropriate.

The contracts funds the printing, stuffing PCB quantities as follow.
- Metlino AMC v1.0: print 10 PCBs, stuff 4
    - [ ] printing complete
    - [ ] stuffing complete
- Sayma AMC v2.0: print 10 PCBs, stuff 6
    - [ ] printing complete
    - [ ] stuffing complete
- Sayma RTM v2.0: print 10 PCBs, stuff 6
    - [ ] printing complete
    - [ ] stuffing complete
- BaseMod v2.0: print 20 PCBs, stuff 12
    - [ ] printing complete
    - [ ] stuffing complete
- TestMod v2.0: print 6 PCBs, stuff 6
    - [ ] printing complete
    - [ ] stuffing complete

Testing of all stuffed PCBs:

- Thermal test in TS7
    - [ ] maximum temperature of measured integrated circuits (IC) < 65 C. Monitor temperature of a subset of ICs using Module Management Controller (MMC)

- MMC configuration including power supply sequencing and IPMI. Contractor shall test MMC firmware on TS7 system prior to distribution.
    - [ ] Publish MCH configuration file used for these tests with TS-MTCA and NATIVE-R5.
    - [ ] Intelligent Platform Management Interface (IPMI).
    - [ ] crate power-on with all boards and with arbitrary RTM unplugged in TS7
    - [ ] Hot swap arbitrary AMC and RTM boards in TS7
    - [ ] Power-on with or without RTM unplugged in TS1

- Signal integrity testing using any suitable FPGA intellectual property (IP) (eg Xilinx) for all ICs. Tested individually. Design and implement test to simulate heavy loading of a system configured as TS2. Two TestMod PCBs are to be installed dissipating representative power for all tests. Tests will simultaneously exercise the following subsystems.
    - [ ] Inter-Integrated Circuit (I2C), serial peripheral interface (SPI), address all ICs round robin at full speed
    - [ ] AD built-in DAC JESD pseudo-random binary sequence (PRB)S test at ten (10) gigabits per second (Gb/s) lane for both DACs
    - [ ] SDRAM PRBS write-then-read
    - [ ] AMC backplane ethernet PRBS at 1 GSPS
    - [ ] Small Form-factor Pluggable (SFP) loop-back PRBS at 6 Gb/s
    - [ ] AMC backplane PRBS at 6 Gb/s
    - [ ] FPGA Mezzanine Card (FMC) loop-back
    - [ ] Realistic FPGA fabric load and clock activity

When testing is complete ship hardware to ARL or designated partner labs.

The hardware contractor retains the following PCBs for testing and as backups in case of system integrator hardware failure: 2 Sayma AMC, 2 Sayma RTM, 4 BaseMod, 1 Metlino.

If errors arise after shipping of hardware, Contractor shall debug and test on TS2.

marmeladapk, 2019-09-30:
@jbqubit It seems that you didn't update test plan with our stress test that we sent you. Can I update your post with it?

Thread 123 (2019-09-09):

HT4 serial no, wiki page for tracking PCB rework

jbqubit, 2019-09-09:
(HT4) Each board should have a serial number and place on a wiki page to document board-specific rework and other board-specific oddities.

jbqubit, 2019-09-24:
Glad the flash writing bugs were found. https://github.com/sinara-hw/Sayma_AMC/issues/126 Good work @marmeladapk!

Please develop a system for naming and documenting the white wire patches. Unknown patch state of specific Sayma v1.0. boards proved problematic. Would like to avoid for Sayma v2.0.

jbqubit, 2019-12-19:
@marmeladapk, @kaolpr Please setup this wiki page. This would be the place to also note which balun is broken on @sbourdeauducq board. The serial numbers and patch records for Sayma v1 was very disorganized. We need to do better on v2.

jbqubit, 2019-12-19:
https://github.com/sinara-hw/Metlino/issues/60#issuecomment-567570494

jbqubit, 2019-12-20:
https://github.com/sinara-hw/Metlino/issues/63#issuecomment-567863867

jbqubit, 2019-12-24:
https://github.com/sinara-hw/Sayma_AMC/issues/132#issuecomment-568152407

jbqubit, 2020-02-04:
This is [here](https://github.com/sinara-hw/Sayma_AMC/wiki/Sayma-v2.0-PCB-modifications).

Closed 2020-02-04.

Thread 124 (2019-09-09):

HT4 formal documentation

jbqubit, 2019-09-09:
Formal hardware documentation for Sayma v2 is to be maintained in github.
- Use the software tool Sphinx.
- Setup automatic rendering on readthedocs.org with webhook to git pushes.
- Embed link in github.com that links to readthedocs.org.
- scope: Expected content is superset of existing Sayma v1.0 documentation

jbqubit, 2020-05-29:
@marmeladapk Who is working on the Sayma v2 documentation? This is an excellent [deliverable](https://github.com/sinara-hw/Sayma_AMC/wiki/Sayma_v2_contract_creotech#c334-ht4-documentation-and-mmc) for COVID-at-home. :)

Getting good documentation is now critical as Oxford @hartytp begins testing of the hardware. Right testing focuses on phase noise. @hartytp took some [notes](https://github.com/sinara-hw/Sayma_RTM/wiki/clocking_synchronisation) on the clock synchronization scheme while bootstrapping his test setup. Having authoritative documentation framework is key to get physicists up and running with minimal fuss -- eg  [DIP switch configuration](https://github.com/sinara-hw/Sayma_RTM/wiki#basic-connections) on AMC -- and so that there's a structure to absorb refinements or extensions to documentation that come from testing in various labs.

Thread 126 (2019-09-11):

Flash memory

marmeladapk, 2019-09-11:
I have a problem with booting up the FPGA from flash. I can program the flash just fine (w/ verification) in Vivado, however the FPGA just won't boot from it.

- I can program the FPGA with JTAG and DONE signal goes high
- program_b, init_b, mode[2:0] seem to be in the correct state (they are controlled from MMC, Vivado also confirms their state; master spi is chosen)
- I observed on scope all lines and I didn't observe activity on IO2 and 3, other lines behave as expected (and signals are not swapped AFAICT)
- After init_b goes high I can observe that the FPGA reads the memory using 3 MHz clock. I can see the 0x0B command (fast read) followed by three 0x00 bytes, so it's a read operation from 0 address. First tens of bytes that I could observe are consistent with beginning of .bin file (modulo some problems with spi decoder).
- Signal integrity and voltage levels seem fine. There are some overshoots and crosstalk, however nothing dramatic that could prevent the memory from working (esp. at this speed)
- I replaced the memory chip with one from Sayma 1.0, they behave the same.
- If I try to dump the memory contents to file (in Vivado) the I usually get only 0xFFs in file (but not always! When I flashed 20k of random bits I could dump them just fine)
- During bootup the FPGA tries to read the memory for tens of seconds (even minutes)
- There are no obvious design changes in schematics that could cause this behaviour (but you can double check me).

gkasprow, 2019-09-11:
a few ideas:
- make sure that IC35 is disabled
- make sure all resistors to RTM are DNP: R223, R224, R225, R226, R227
- make sure that MMC does not mess up with INIT_B, PROGRAM_B, DONE, you can remove R244, R242, R243
- generate FLASH content with a low-speed setting (1MHz) and QSPI disabled.
- remove the C511 or R253. It is a modification of the Xilinx recommendation, even though it worked in rev1

marmeladapk, 2019-09-20:
Ha! I found it!
TL;DR: Removing C511 or R253 helps.

We had quite a few red herrings, that's why it took so long to debug it.

We had a proper openMMC config with which the FPGA did not program. However it reacted properly to program_b and init_b signals, started SPI communication and issued correct commands (and memory responded to them). Clock looked correct, though with some smooth falling edges. Data had some pretty high overshoots.

We also had an incorrect MMC config, which (by accident) turned high program_b and reset_n before all voltages were stable. The FPGA then programmed correctly, however all SPI levels were around 2,5V, everything else was the same. It didn't program again when we pulsed program_b. It seems that program_b and reset_n powered 3V3 rail for around 100ms and it caused _something_ to happen which caused lower voltages on SPI (probably some parasitic diode or something).

It turns out that the culprit was crosstalk + high overshoots on data + slow falling edge on clk. For example in this event:
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
most probably there was an additional clock cycle registered (1-clock, 2,3-mosi, miso, 4-cs). With smaller voltages on SPI bus (with incorrect config) clock returned more quickly below threshold and crosstalk was less dramatic bc. of smaller rising edge.

With C511 removed:
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
FPGA programs correctly on both Saymas.

But removing C511 only masks the real problem which are high over- and undershoots (>1 V!) and high crosstalk. in UG570 Xilinx reccomends series resistors to minimalize overshoots. Crosstalk is also pretty bad, QSPI lines travel sometimes for centimeters separated only with minimal gap. They also have much lower rise time than I expected (5 ns).

So overall if we plan to do 2.1 we should simulate and insert those series resistors and maybe space QSPI lines a bit if it's possible at all. @gkasprow what do you think?

gkasprow, 2019-09-20:
True, The clock line should b routed away from the data line.  I overlooked this. Series termination on FLASH side won't harm. In Sayma v1.0 there was no length matching and the clock line was separated from data.
I asked you to remove C511 already a few posts above :)

marmeladapk, 2019-09-20:
Yes, however there other issues which seemed more probable which I tested first.

jordens, 2019-09-20:
Nice!

jbqubit, 2019-09-24:
Nice find! I made a v2.1 milestone and tagged the issues made by @marmeladapk.

marmeladapk, 2019-09-30:
DNPed R253 until #129 is implemented.

Closed 2019-09-30.

Thread 127 (2019-09-20):

INIT_B should have 4k7 pullup resistor

marmeladapk, 2019-09-20:
Instead of 200 Ohm. Tested that it works with 4k7 during debugging of #126.

It's only a BOM change so we could implement it before the next bath is produced.

Closed 2019-09-30.

Thread 130 (2019-09-25):

3V3_MP overcurrent during RTM startup

marmeladapk, 2019-09-25:
(Most probably it's overcurrent, we saw large dips in voltage when RTM started).
Changing R92 to 100k helped in Native-R5, but we'll need to test it on the rest of the boards.

@sbourdeauducq your AMC doesn't have this fix.

sbourdeauducq, 2019-09-25:
Where is R92?

marmeladapk, 2019-09-25:
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

marmeladapk, 2019-09-30:
@sbourdeauducq Due to confusion if we can send this board I had a moment to implement this change on your Sayma.

Closed 2019-09-30.

Thread 132 (2019-10-04):

jumper to disable microTCA hotplug switch

sbourdeauducq, 2019-10-04:
Since Creotech are shipping boards without front panels (which are delayed), add a jumper to force the µTCA hotplug switch on. Putting tape on it to turn it on is annoying and unreliable.
Same on RTM.

marmeladapk, 2019-10-05:
This is a one-off issue. Next batch will have panels already. Besides it's easier to force power on in MMC (or even use the front panel button). Jumper isn't needed IMO.

sbourdeauducq, 2019-10-06:
> Besides it's easier to force power on in MMC

Does this involve IPMI or NATview? If so, it's not easier than a jumper.
Is the front panel button currently wired to force power to both AMC and RTM? This does not sound like such a great idea as users may inadvertently push it while hotplugging boards.

kaolpr, 2019-10-06:
No, it does not involve IPMI / NATview. What @marmeladapk proposed is modification to AMC MMC, which manages RTM power supply. We can than use AMC reset button to signalize MMC that RTM / AMC is to be switched on/off. Please note that this is **temporary workaround** until panels are produced. Currently, there is very limited number of users (actually, besides Creotech you are the only one), so we believe that exposition on inadvertent actions is minimal.

marmeladapk, 2019-10-06:
Or you could turn it on and off using mmc console simulating hotswap position to MMC.

sbourdeauducq, 2019-10-16:
Any update on those front panels?
Also, how do I force power on with the MMC console?

marmeladapk, 2019-10-16:
@sbourdeauducq We should get all front panels on the last week of October.

> how do I force power on with the MMC console?

Currently you can't, we'd have to add this to MMC console. Is this critical for you now?

sbourdeauducq, 2019-10-16:
Not critical but replacing the tape on the switches every few days is annoying. I guess I could also solder them short...

sbourdeauducq, 2019-12-15:
@marmeladapk Any update on the front panels or MMC firmware with that feature?

sbourdeauducq, 2019-12-21:
> MMC firmware with that feature

Nevermind, I soldered the switches short.

As @jbqubit reminded you, please create a wiki page listing all boards and where one can log reworks made to them.

Thread 133 (2019-10-04):

xlsx/schematics mismatch

sbourdeauducq, 2019-10-04:
The .xlsx file with the FPGA pin assignments for v2.0rc8 (production) does not match the schematics.

This shows FPGA pin E28 assigned to DDR3_32_DQS3_N:
https://github.com/sinara-hw/Sayma_AMC/releases/download/v2.0rc8/Sayma_AMC_FPGA_pins.xlsx

This shows FPGA pin E28 assigned to DDR3_32_DQ5:
https://github.com/sinara-hw/Sayma_AMC/releases/download/v2.0rc8/Sayma_AMC.PDF

Which one corresponds to the boards that have been produced?

@gkasprow Can you PLEASE be VERY careful about this sort of thing? This recurrent pattern has been causing us a lot of problems.

gkasprow, 2019-10-04:
I traced back what happened.
After I moved from EE to ALtium, the translator mirrored the schematic symbol. S, all DDR32 pins are mirrored in the xlx file.
During routing I noticed that and fixed.
The xls file is very old (march 2019). I forgotten to generate the new one.
I updated the xls file in the release
https://github.com/sinara-hw/Sayma_AMC/releases/tag/v2.0.1

sbourdeauducq, 2019-10-04:
Is this 2.0.1 tag still applicable to the v2 boards that have been already produced?
What are the differences?

gkasprow, 2019-10-04:
Yes, only xls file was not updated.

marmeladapk, 2019-10-06:
@sbourdeauducq https://github.com/sinara-hw/Sayma_AMC/commit/75b020da3583e4195b526ac2c1a2b15560f89bde

Closed 2019-10-04.

Thread 136 (2019-10-08):

detection of RTM hotplugging?

sbourdeauducq, 2019-10-08:
How to detect from the AMC that the RTM is being unplugged/re-plugged?
Now that the AMC-RTM link is using DRTIO, we can support RTM hotplug without a lot of trouble; we just need to reload the RTM FPGA when the RTM is plugged in and make sure that the JESD core is properly reset.

kaolpr, 2019-10-08:
Hotplug switch on RTM is connected to the GPIO expander, which is connected to AMC I2C subsystem. Thus you can access it using AMC MMC or FPGA I2C master.

jbqubit, 2020-01-17:
Any luck with this @sbourdeauducq ?

marmeladapk, 2020-01-27:
@sbourdeauducq We detect RTM using MMC and it uses FPGA_STATUS to signal this to AMC FPGA. High if RTM is detected and has enabled power, low otherwise. But first we must fix https://github.com/sinara-hw/Sayma_AMC/issues/145.

sbourdeauducq, 2020-01-27:
OK, sounds good.

Thread 138 (2019-11-12):

Change R91 to 100k

marmeladapk, 2019-11-12:
Fixes AMC+RTM startup in Native-R5 (previously disabled 12V for whole crate including fans).

Thread 139 (2019-12-07):

WR FF to FPGA connection

sbourdeauducq, 2019-12-07:
Why are there both single-ended SSTL18 connections and differential SSTL15?
Which one is populated on the boards?

Also this indication of "LVDS" is misleading:
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

@gkasprow

gkasprow, 2019-12-07:
They are just in case. There is a note below that explains this.
LVDS is just a routing rule.
At the moment the single-ended SSTL18 is populated, so do not use the differential ones.
It is a source terminated.

sbourdeauducq, 2019-12-08:
Currently I cannot get any signal out of those FFs.
The FPGA constraints I am using are:
```
Subsignal("rec_clk", Pins("F12"), IOStandard("SSTL18_I")),
Subsignal("main_xo", Pins("L9"), IOStandard("SSTL18_I"))
```
Are they correct?

gkasprow, 2019-12-08:
They look fine.
Please, look with fast scope at the pins 14, 15 and 16, 17 of IC19.
If you don't have such fast scopes, measure DC voltages instead.

gkasprow, 2019-12-08:
@marmeladapk did you check this circuit?

marmeladapk, 2019-12-09:
@sbourdeauducq We checked `DDMTD_OUT_MAIN_CLK_SSTL18`. And the signal that we got out of it looked fine. We used the same IO standard as you. Do you have both main and helper clock signals?

With CDR we had a problem to get clock out of MGT. It didn't work on the first few tries, so we moved to other issues.

sbourdeauducq, 2019-12-09:
I have both working now (since today).
The GTH needs this: https://github.com/m-labs/artiq/commit/307a6ca140b1cea8cf0c08072fb733312de6fd0a

sbourdeauducq, 2019-12-09:
Another issue was this: https://github.com/m-labs/artiq/commit/14e09582b6ea141624d3f50d85498d4590f55c7c

marmeladapk, 2019-12-20:
@sbourdeauducq Can we close this?

sbourdeauducq, 2019-12-20:
Just two issues remain:
1. While I am getting consistent DDMTD data from the main XO FF, the DDMTD data from the GTH FF is unexplained. I do not know where the problem is coming from. FWIW, I am also getting inconsistent data with the RTM implementation that does not use FFs, so it is perhaps not the FFs.
2. If we don't use the differential signal, it should perhaps be removed.

jbqubit, 2019-12-20:
I created separate issue about the misleading LVDS label. https://github.com/sinara-hw/Sayma_AMC/issues/143

jbqubit, 2020-01-17:
@sbourdeauducq Can this be closed?

sbourdeauducq, 2020-01-17:
No, there should still be a decision about which signal (SE or differential) to keep, and then remove the other.

Thread 140 (2019-12-08):

LVDS termination for signals received from Si549s

sbourdeauducq, 2019-12-08:
Should the FPGAs enable integrated LVDS terminations (DIFF_TERM=TRUE) for those signals that it receives from the DCXOs?

I suppose that should use the LVDS standard even when the DCXO is CMOS, so that LVDS DCXOs can be used instead without changing the bitstream.

(Same question for AMC and RTM)

gkasprow, 2019-12-08:
Actually, the CMOS oscillators are not stocked and we will use LVDS ones. At least in Metlino.
You can use either 2x SSTL18 or LVDS. The latter consumes less current.

sbourdeauducq, 2019-12-08:
Ok, and should there be DIFF_TERM=TRUE or not? And I was asking about Sayma v2 (the boards that have already been produced) and Kasli v2.

jbqubit, 2020-01-17:
How was this resolved?

Thread 141 (2019-12-09):

DAC testing

marmeladapk, 2019-12-09:
@jbqubit asked me to write about our problems with getting DAC output. This was the only real obstacle for us to finish HT3 currently (because DAC output is required for tests in crate) and to distribute hardware.

We were using AD IP-core for JESD and with it we couldn't get a stable JESD link. Initial phases went ok but it failed at synchronization phase.
Recently @atcher0 used Xilinx IP-core for JESD, which established the link. Today we got output on all channels (JESD subclass 1, so with synchronization)! The only problem is that some channels have 10x the signal than others, however we still need to write controls for attenuators properly, so this may solve itself quickly.

In parallel I was testing if ARTIQ was providing DAC output. I'm using eb271f38 from ARTIQ. Initially I got `DAC sync failed: no sync lock`. This was caused by no signal on HMC7043 SYSREF outputs. After fixing this (pull request https://github.com/m-labs/artiq/pull/1402 ) I got stuck on `failed to align SYSREF at DAC: no rotation seen when scanning DAC SYSREF delay`. When I checked SYSREF input, the signal was changing phase, so I don't know the cause.

Anyway, I used Kasli as SAWGMaster + code from sines_2sayma example. I used testmod, which outputs the signal directly. No signal is present at any output. Btw heads up @sbourdeauducq, we think that baluns on testmods may be broken, because we get output on basemods and not on testmods (or pin assignment is wrong).

I think we'll work in parallel on Xilinx IP-core (we've got eval license until March) and I can work with @sbourdeauducq on ARTIQ, since we have the same setup now.

gkasprow, 2019-12-09:
baluns are extremely fragile and  can be damaged easily

jbqubit, 2019-12-09:
@sbourdeauducq Did you receive AFEs from Creotech?

jbqubit, 2019-12-09:
> The only problem is that some channels have 10x the signal than others, however we still need to write controls for attenuators properly, so this may solve itself quickly.

What do you see on TestMod? If your baluns are broken replace them.

atcher0, 2019-12-09:
Screenshot of DAC outputs (from BaseMod):
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

hartytp, 2019-12-09:
Cool!

jbqubit, 2019-12-09:
Great!

sbourdeauducq, 2019-12-10:
> Anyway, I used Kasli as SAWGMaster + code from sines_2sayma example.

For checking if the DAC has any output at all, I suggest compiling the AMC gateware with the ``--without-sawg`` option instead. This is faster to compile, and there's a much simpler stack with fewer things that can go wrong. Every DAC channel outputs a signal at all times (hardcoded in gateware).

> Did you receive AFEs from Creotech?

Yes, I did.

marmeladapk, 2020-01-15:
Today, after following @sbourdeauducq instructions, I used artiq release-5 (without sawg) and I got output on one of the DACs.

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

jbqubit, 2020-01-16:
Did the other channels fail or were they not tried?

sbourdeauducq, 2020-01-16:
They fail, the JESD core for DAC0 fails systematically on all boards with a "not ready" error.

marmeladapk, 2020-01-16:
This depends, I recall that on previous builds Dac1 was reported as not
ready.

czw., 16 sty 2020, 02:01 użytkownik Sébastien Bourdeauducq <
notifications@github.com> napisał:

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

jbqubit, 2020-01-17:
Recap from chat with @marmeladapk. He sent a working example (.bit) to M-Labs that exercises the DACs using Creotech+Xilinx IP. His example produces RF output on all channels on his boards. And it checks a DAC register to confirm if SYSREF signal is present on the DAC side. He prefers to wait to send replacement hardware to M-Labs until more is known about this being a hardware vs ARTIQ config issue.

sbourdeauducq, 2020-01-19:
Trying to narrow down the bug...

The "not ready" error on DAC0 is still present with the JESD core modified like this:
```
diff --git a/jesd204b/link.py b/jesd204b/link.py
index d3e9ef3..c142956 100644
--- a/jesd204b/link.py
+++ b/jesd204b/link.py
@@ -292,9 +292,7 @@ class JESD204BLinkTX(Module):
             source.data.eq(cgs.source.data),
             source.ctrl.eq(cgs.source.ctrl),
             # start ILAS on first LMFC after jsync is asserted
-            If(jsync & jref_rising,
-                NextState("ILAS")
-            )
+            NextState("USER_DATA")
         )

         # Initial Lane Alignment Sequence
```

But it goes away when it is modified like this:
```
diff --git a/jesd204b/core.py b/jesd204b/core.py
index 1a6f563..e80bd38 100644
--- a/jesd204b/core.py
+++ b/jesd204b/core.py
@@ -141,7 +141,7 @@ class JESD204BCoreTXControl(Module, AutoCSR):

             self.jsync.status.eq(core.jsync_sys),

-            self.ready.status.eq(core.ready)
+            self.ready.status.eq(1)
         ]

         # restart monitoring
```

sbourdeauducq, 2020-01-19:
This also makes the error disappear:
```
diff --git a/jesd204b/core.py b/jesd204b/core.py
index 1a6f563..505f2cc 100644
--- a/jesd204b/core.py
+++ b/jesd204b/core.py
@@ -72,7 +72,7 @@ class JESD204BCoreTX(Module):
             self.submodules += link
             links.append(link)
             self.comb += [
-                link.reset.eq(link_reset),
+                link.reset.eq(0),
                 link.jsync.eq(self.jsync_jesd),
                 link.jref.eq(self.jref)
             ]
```

``link_reset`` is generated like this:
```
self.comb += link_reset.eq(~reduce(and_, [phy.transmitter.init.done for phy in phys]))
```

It could be that some of the GTH transceivers on the DAC0 lanes fail to initialize (marginal operating conditions?).

@marmeladapk How did you clock the transceivers in your tests where the DACs worked? I'm running them from the Si5324 and it could be that excessive jitter aggravates the problem?

enjoy-digital, 2020-01-19:
@sbourdeauducq: the AD9154 is able to report a status for the CGS/ILAS, i think you should make the firmware output it (it was possible in previous firmware IIRC). First see if CGS is passing (with the registers of the AD9154 or by looking at the JSYNC since JSYNC is asserted when CGS is detected on all lanes). Then if CGS is fine, get the ILAS status from the AD9154. Also, you should be able to use PRBS without the AD9154 fully syncing, we only need to have the AD9154  PLL to be locked for that. This would help narrowing down the issue.

sbourdeauducq, 2020-01-19:
Thanks for the information.
Yes, the DAC diagnostics code is still there.
But it seems to me that the JESD core fails without any involvement of the DAC. The JSYNC line is only used in link.py, and when I ignore it with this patch:
```
-            If(jsync & jref_rising,
-                NextState("ILAS")
-            )
+            NextState("USER_DATA")
         )
```
then the problem is still present.

This patch:
```
-                link.reset.eq(link_reset),
+                link.reset.eq(0),
```
seems to indicate that the problem is coming from ``link_reset``, which itself is derived from the GTH - the latter, like most XilinxⓇ hardware blocks, being a notorious troublemaker.

Am I missing out something?

enjoy-digital, 2020-01-19:
Indeed, you also have to check that the GTH are initialized correctly and init going to READY state on all lanes: https://github.com/m-labs/jesd204b/blob/master/jesd204b/phy/gth_init.py#L111

sbourdeauducq, 2020-01-19:
Using cdr_clk_clean_2 or cdr_clk_clean_3 to clock JESD has no impact on the behavior.

sbourdeauducq, 2020-01-19:
> Indeed, you also have to check that the GTH are initialized correctly and init going to READY state on all lanes: https://github.com/m-labs/jesd204b/blob/master/jesd204b/phy/gth_init.py#L111

With this patch, there's still "ready timeout" on DAC0 and not on DAC1:
```
diff --git a/jesd204b/phy/gth_init.py b/jesd204b/phy/gth_init.py
index e048a0a..8bd3ca4 100644
--- a/jesd204b/phy/gth_init.py
+++ b/jesd204b/phy/gth_init.py
@@ -7,7 +7,7 @@ from migen.genlib.misc import WaitTimer

 class GTHInit(Module):
     def __init__(self, sys_clk_freq, rx):
-        self.done = Signal()
+        self.done = Signal(reset=1)
         self.restart = Signal()

         # GTH signals
@@ -49,10 +49,11 @@ class GTHInit(Module):
         startup_fsm = ResetInserter()(FSM(reset_state="RESET_ALL"))
         self.submodules += startup_fsm

+        done = Signal()
         ready_timer = WaitTimer(1*sys_clk_freq//1000)
         self.submodules += ready_timer
         self.comb += [
-            ready_timer.wait.eq(~self.done & ~startup_fsm.reset),
+            ready_timer.wait.eq(~done & ~startup_fsm.reset),
             startup_fsm.reset.eq(self.restart | ready_timer.done)
         ]

@@ -109,5 +110,5 @@ class GTHInit(Module):
             If(Xxphaligndone_rising, NextState("READY"))
         )
         startup_fsm.act("READY",
-            self.done.eq(1)
+            done.eq(1)
         )
```

enjoy-digital, 2020-01-19:
I'm not sure what's the patch is doing, be the checks that needs to be done are:
- are all the GTH initialized correctly if a the clock is provided and restart pulsed once?
- if so, then check if CGS is received correctly by the DAC. If not, then maybe do a check with another clock if you have doubt with the one used.

sbourdeauducq, 2020-01-20:
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

Ignore this. The behavior is non-deterministic and it could just have been chance.

sbourdeauducq, 2020-01-20:
Also there are multiple layers to this bug. I have added GTH init diagnostics:
https://github.com/m-labs/artiq/commit/eb0ce933c59292628196d865f0fbef77cae6397f
https://github.com/m-labs/jesd204b/commit/ed7dc91686f6c340dc8b14e5a119d5e4bbcf9339

Sometimes it fails with "JESD core PHY not done" (which previously would have been indistinguishable from other problems), and sometimes with the "not ready" error from other causes.

enjoy-digital, 2020-01-20:
To ease debug, maybe you should disconnect the JSYNC from the restart here:
https://github.com/m-labs/jesd204b/blob/master/jesd204b/core.py#L36 or add a control signal (jsync_enable?) that you could control from the firmware. This way, once the firmware enable the JESD PHYs, link, core, there will be a single attempt to initialize the link, and looking having a "JESD core PHY not done" would really mean the PHY are not initializing correctly and that there is an issue here. Can you use the same clock source that is used for the demo with the Xilinx core?

sbourdeauducq, 2020-01-20:
What is the purpose of reinitializing the transceivers when JSYNC gets deasserted?

sbourdeauducq, 2020-01-20:
I also don't get why the transceivers should be restarted when ``self.prbs_config == 0``.

sbourdeauducq, 2020-01-20:
```
diff --git a/jesd204b/core.py b/jesd204b/core.py
index 24fe046..28291e8 100644
--- a/jesd204b/core.py
+++ b/jesd204b/core.py
@@ -88,8 +88,7 @@ class JESD204BCoreTX(Module):
             ]

             # connect control
-            self.comb += phy.transmitter.init.restart.eq(
-                    self.restart & (self.prbs_config == 0))
+            self.comb += phy.transmitter.init.restart.eq(~self.enable)

             self.specials += MultiReg(self.prbs_config,
                                       phy.transmitter.prbs_config,
```
Should I merge this?

sbourdeauducq, 2020-01-20:
Shouldn't this restart be simply handled in ``link.py``: in the ``USER_DATA`` state, if ``jsync`` goes to 0, then return to ``CGS``?

sbourdeauducq, 2020-01-20:
https://github.com/m-labs/jesd204b/commit/2d135e3a482bf7571eb272fab61eaffc345a0f7d @enjoy-digital can you review?

enjoy-digital, 2020-01-20:
The transceivers were reinitialized because we don't know the reason of JSYNC de-assert from the DAC and could be caused by the transceiver not operating correctly. The restart was only enabled when PRBS was not used.

Your changes seems fine yes and should simplify understanding the issue. The "JESD core PHY not done" was probably that JESD was constantly re-initialized and that the ready CSR was read while the PHY was still doing the initialization.

So now that you know the PHY are initialized correctly, the next step is to enable debug on the DAC and get the CGS/ILAS status.

sbourdeauducq, 2020-01-20:
Yes, this separation and the diagnostic make things a lot clearer!
It now seems JSYNC is the issue. Could be this https://github.com/sinara-hw/Sayma_AMC/issues/148 ... sigh

sbourdeauducq, 2020-01-20:
Changing to LVDS3/LVDS11:
```
--- a/migen/build/platforms/sinara/sayma_amc2.py
+++ b/migen/build/platforms/sinara/sayma_amc2.py
@@ -258,13 +258,13 @@ _io = [
         IOStandard("LVDS"), Misc("DIFF_TERM_ADV=TERM_100")
     ),
     ("dac_sync", 0,
-        Subsignal("p", Pins("J8")),
-        Subsignal("n", Pins("H8")),
+        Subsignal("p", Pins("L8")),
+        Subsignal("n", Pins("K8")),
         IOStandard("LVDS"), Misc("DIFF_TERM_ADV=TERM_100")
     ),
     ("dac_sync", 1,
-        Subsignal("p", Pins("J13")),
-        Subsignal("n", Pins("H13")),
+        Subsignal("p", Pins("J9")),
+        Subsignal("n", Pins("H9")),
         IOStandard("LVDS"), Misc("DIFF_TERM_ADV=TERM_100")
     ),
     ("dac_jesd", 0,
```
does not improve things (I'm now getting errors on both DACs).
Let's wait for @gkasprow to tell us on which pins those JSYNC signals really are.

sbourdeauducq, 2020-01-20:
It turns out that the pins in current Migen are OK.
I'm now printing the the DAC status when the error happens: https://github.com/m-labs/artiq/commit/c4e4d67cdf0a8d00a4148808a72fff6c826e0fd5
the DAC looks quite unhappy:
```
[     2.332374s]  INFO(board_artiq::ad9154): AD9154-0 found
[     2.337605s]  INFO(board_artiq::ad9154): AD9154-1 found
[     2.349938s]  INFO(satman): uplink is up, switching to recovered clock
[     2.384434s]  INFO(board_artiq::si5324): waiting for Si5324 lock...
[     3.990946s]  INFO(board_artiq::si5324):   ...locked
[     6.707777s]  INFO(board_artiq::si5324::siphaser): calibration successful, lead: 94, width: 426 (342deg)
[     7.014068s]  INFO(satman): TSC loaded from uplink
[     7.065047s]  INFO(board_artiq::ad9154): Status of DAC-0
[     7.069018s]  INFO(board_artiq::ad9154): SERDES_PLL_LOCK: 0
[     7.074613s]  INFO(board_artiq::ad9154):
[     7.078650s]  INFO(board_artiq::ad9154): CODEGRPSYNC: 0x00
[     7.084167s]  INFO(board_artiq::ad9154): FRAMESYNC: 0x00
[     7.089508s]  INFO(board_artiq::ad9154): GOODCHECKSUM: 0x00
[     7.095113s]  INFO(board_artiq::ad9154): INITLANESYNC: 0x00
[     7.100707s]  INFO(board_artiq::ad9154):
[     7.104745s]  INFO(board_artiq::ad9154): DID_REG: 0x00
[     7.109911s]  INFO(board_artiq::ad9154): BID_REG: 0x00
[     7.115077s]  INFO(board_artiq::ad9154): SCR_L_REG: 0x00
[     7.120418s]  INFO(board_artiq::ad9154): F_REG: 0x00
[     7.125410s]  INFO(board_artiq::ad9154): K_REG: 0x00
[     7.130401s]  INFO(board_artiq::ad9154): M_REG: 0x00
[     7.135392s]  INFO(board_artiq::ad9154): CS_N_REG: 0x00
[     7.140646s]  INFO(board_artiq::ad9154): NP_REG: 0x00
[     7.145725s]  INFO(board_artiq::ad9154): S_REG: 0x00
[     7.150716s]  INFO(board_artiq::ad9154): HD_CF_REG: 0x00
[     7.156057s]  INFO(board_artiq::ad9154): RES1_REG: 0x00
[     7.161311s]  INFO(board_artiq::ad9154): RES2_REG: 0x00
[     7.166622s]  INFO(board_artiq::ad9154): LIDx_REG: 0x00 0x00 0x00 0x00 0x00 0x00 0x00 0x00
[     7.174941s]  INFO(board_artiq::ad9154): CHECKSUMx_REG: 0x00 0x00 0x00 0x00 0x00 0x00 0x00 0x00
[     7.183697s]  INFO(board_artiq::ad9154): COMPSUMx_REG: 0x00 0x00 0x00 0x00 0x00 0x00 0x00 0x00
[     7.192309s]  INFO(board_artiq::ad9154): BADDISPARITY: 0x00
```

This was with reinitializations disabled (but it seems it doesn't initialize at all anyway):
```
diff --git a/jesd204b/link.py b/jesd204b/link.py
index 89cebaf..9584d54 100644
--- a/jesd204b/link.py
+++ b/jesd204b/link.py
@@ -312,5 +312,5 @@ class JESD204BLinkTX(Module):
             ilas.reset.eq(1),
             self.ready.eq(1),
             source.eq(inserter.source),
-            If(~jsync, NextState("CGS"))
+            #If(~jsync, NextState("CGS"))
         )
```

enjoy-digital, 2020-01-20:
From what i remember, even without JESD at all, SERDES_PLL_LOCK should be set to 1 with just the AD9154 SPI init and a valid clock input.

sbourdeauducq, 2020-01-20:
Thanks for the hint.
https://github.com/m-labs/artiq/commit/f4a5c4503d63943cb90749b3c07ddb3d87fc5df9

Now JESD ready passes on both DACs, and DAC0 is working!
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
(ignore the funny voltage readings, scope is configured for 100x probe but connected directly to Sayma)

(I don't understand why DAC1 JESD ready passed though)

DAC1 still shows the STPL error, but this could be a one-off problem with my board (since it was working before already on the boards at Creotech). @marmeladapk Can you try on your boards?

sbourdeauducq, 2020-01-20:
SAWG + TTL output
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

marmeladapk, 2020-01-22:
I had a moment to test it on DAC0 on one of the boards with simple sine wave. It seems to work. I didn't try anything more complicated.

Thread 142 (2019-12-19):

BaseMod RF, output amplitude inconsistent

jbqubit, 2019-12-19:
Issue raised on call with Creotech on 12/18. "RF output has correct frequency but every second channel has 2x amplitude." @marmeladapk says this might be due to error in BaseMod configuration.

@sbourdeauducq Has M-Labs written a driver for BaseMod yet? I gather Cretoech would appreciate using your driver as a reference design.

gkasprow, 2019-12-19:
Unitinialised attenuators often setup in a random way, I noticed it on Urukul.

marmeladapk, 2019-12-20:
@jbqubit It not an error per se in configuration, it's just lack of configuration ;)

marmeladapk, 2019-12-20:
@atcher0 fixed it yesterday before we had a chance to tell him that it's not needed.

sbourdeauducq, 2019-12-20:
FWIW, the HMC542 register says that reset held low "clears the shift register".
I do not know if reset affects the latch (I suppose we have to measure that ourselves, as is often the case when using anything from HMC) and thus if a pull-down resistor on reset would help with this minor wrinkle.

sbourdeauducq, 2019-12-20:
The schematic says it does not affect the latch:
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

So it would be pull-down on reset and pull-up on LE.

gkasprow, 2019-12-20:
Yes, but first, someone must toggle the reset line :)

sbourdeauducq, 2019-12-20:
According to the datasheet, reset is level-sensitive. But we would have that problem with the latch signal, yes (which is rising edge sensitive).
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

sbourdeauducq, 2019-12-20:
So if we really care about this, we need some complicated power-up sequencing of LE and reset pullup/pulldowns. HMC design strikes again...
But since there are also RF switches on our PCB, it doesn't really matter.

sbourdeauducq, 2019-12-20:
And it's not a "latch" but a D flip-flop...

sbourdeauducq, 2019-12-21:
> @sbourdeauducq Has M-Labs written a driver for BaseMod yet? I gather Cretoech would appreciate using your driver as a reference design.

Yes and it seems to work - at least I can read back the values.
See the latest commits in the ARTIQ repos.

Closed 2019-12-20.

Thread 144 (2019-12-21):

flimsy µTCA hotplug switches on NAT modules

sbourdeauducq, 2019-12-21:
The hotplug switches on NAT modules (NAT-MCH and AC-600D power supply) are unreliable.

Sometimes the crate shuts down because a slight vibration of the table caused a glitch in the switch and detection of a hotplug event. Or sometimes, the hotplug handle, even though it is fully inserted, needs to be wiggled a bit for the crate to start.

Is this a known problem and what is the solution?

jbqubit, 2019-12-24:
@vdirksen and @gkasprow might have thoughts on this.

kaolpr, 2019-12-24:
Unfortunately @vdirksen passed away this year.

marmeladapk, 2020-01-17:
One of @jbqubit 's MCH also exhibits this behaviour.

jbqubit, 2020-01-22:
I've sent notice about this and several other Issues to support@nateurope.com.

jbqubit, 2020-01-27:
Response from NAT is below. It looks like they didn't even read this Issue. I'll encourage them to use github.

> There should be no principle problem with the hotswap handles. Does this happen with one specific module, one module type (PM, MCH) or with multiple? Do you see any unusual mechanical behavior of the handle?

Thread 145 (2020-01-10):

RTM hotswap

marmeladapk, 2020-01-10:
### Problems

- When RTM power is disabled, FPGA unprogrammed
  - PDONE LED is on, however when I touch the gate of transistor with oscilloscope probe it turns off, I measure around 450 mV
  - P3V3 has 2,7V

### Signals between AMC and RTM FPGAs and ICs

- RTM UART - 400 mV
- RTM_FPGA_CFG
  - INIT_B 1,4V
  - Done 400mV (but LED shuts off so measurement changes state)
  - Program_b 400mV
  - CCLK 400mV
  - DIN 400mV
- RTM I2C
  - 3,3V and talks (however it's connected to 3V3MP on AMC)
  - TMP_SENS is pulled up to P3V3 and has 2,8V (but it could be from another source, MMC doesn't seem to be talking there)
- RTM_JTAG - potential cause, has pullups, however without USB plugged in 3V3 on RTM is also high
  - **TMS 3,3V**
  - **TDI 3,3V**
  - TDO 1,7V
  - **TCK 3,3V**
    - AMC: PROG_TCK 3,2V
  - AMC has internal resistive pullup on these pins
- FPGA_LINK GTP

### Fixes for ARTIQ

- rtm_fpga_cfg -> done pin - shouldn't have pullup - DONE signal already has internal pullup in RTM FPGA and sets signal high before RTM FPGA has power
- init_b, program_B shouldn't have pullups as well

### Removing IC15 & IC13

- When I removed IC15 P3V3 voltage dropped to 2,5V from 2,7V when RTM was not powered
- When I removed IC13 & IC15 P3V3 voltage dropped to 0V + PDONE is no longer illuminated
- Only P3V3MP LED is illuminated
- Pressing hotswap turns on all supplies as expected

So IC15 and IC13 shouldn't supply high level signal to RTM when RTM is disabled.

marmeladapk, 2020-01-15:
Possible ways to move forward with current boards:
- abandon hotswap on RTM until v2.1
- rework AMC boards
    - remove IC13, IC14
    - populate R59-R62 (JTAG bypass)
    - this will remove RTM and FMC from JTAG chain

Thoughts @jbqubit, @gkasprow ?

gkasprow, 2020-01-15:
We don't need hot-swap anyway, do we? Software does not support it.

jbqubit, 2020-01-15:
RTM hotswap is a low-priority feature. If skipping hotswap for now helps things move forward faster let's do that.

Thread 146 (2020-01-17):

No power to some cards in crate

marmeladapk, 2020-01-17:
- Multiple Sayma cards in R5 crate (crate power turned off)
- NAT MCH
- All AMCs have inserted hotswap

When turning on crate power, MCH boots up and grants payload power to 1-2 boards (always in the same slots).

jbqubit, 2020-01-22:
@marmeladapk Please post your MCH configuration file so NAT Support can take a look.

marmeladapk, 2020-01-27:
Same as with https://github.com/sinara-hw/Sayma_AMC/issues/147

One other thing that changed was switching back to debug compilation instead of release.

jbqubit, 2020-01-27:
This isn't really a satisfactory resolution. Which device are you compiling for as regards debug/release?  NAT's response is the following.

> Can you please provide a full system information log file of the system? You can create the log archive via the web interface of the MCH.

Thread 147 (2020-01-17):

Red LED on MCH in some crate slots

marmeladapk, 2020-01-17:
Some Saymas aren't communicating properly with MCH when inserted in some slots.

(we'll provide more details next week)

jbqubit, 2020-01-22:
@marmeladapk What are details?

marmeladapk, 2020-01-27:
It seems that some cards had troubles in 1st, 3rd and 5th slot, however when we didn't get any meaningful conclusion when we tried to pinpoint this issue. It seems to be solved now by changing something unrelated to communication with MCH. I know that this isn't a satisfactory answer, however previously troublesome cards are now working fine in multiple configurations in crate.

Closed 2020-01-27.

Thread 149 (2020-02-28):

P5V0 PGOOD pulsates on AMC #111

marmeladapk, 2020-02-28:
Yellow: P5V0; Blue: P5V0_PGOOD
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

It starts pulsating after enabling P1V0, however even before that there are really small spikes in P5V0 which cause PGOOD to go low for microsecond:
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

It seems like it's already on the verge of stability.

Current draw seems normal (0,5 A with all supplies enabled and FPGA not programmed), maybe 20 mA @12 V more than usual, but it may be a red herring.

marmeladapk, 2020-03-02:
My bad. It's probably after enabling P3V3_CLK that the PGOOD start pulsating.

Current draw is 668 mA (I connected external PSU).

marmeladapk, 2020-03-02:
Fixed after resoldering IC24. Ran full stress test without any problems.

Closed 2020-03-02.

Thread 150 (2020-03-31):

AMC photos

jbqubit, 2020-03-31:
Please post photos of the stuffed Sayma_AMC for contract accounting.

https://github.com/sinara-hw/Sayma_AMC/wiki/Sayma_v2_contract_creotech#c332-ht3-manufacturing-baseline-testing

Sayma AMC v2.0: print 10 PCBs, stuff 6

akaminska, 2020-04-07:
1907180PW0009A0103
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

akaminska, 2020-04-07:
1907180PW0009A0104
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

akaminska, 2020-04-07:
1907180PW0009A0106
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

akaminska, 2020-04-07:
1907180PW0009A0105
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

akaminska, 2020-04-07:
1907180PW0009A0107
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

akaminska, 2020-04-07:
1907180PW0009A0108
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

akaminska, 2020-04-07:
Unpopulated PCBs
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

jbqubit, 2020-04-07:
Thank you. Please also post photo of at least one AMC with front panel installed. Ideally front view.

akaminska, 2020-04-10:
Please remember that these panels are "prototypes" as well, we definitely aim for better quality for the final product...
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

jbqubit, 2020-04-10:
Thank you.

Closed 2020-04-10.

Thread 151 (2020-03-31):

PCB modifications refactor

jbqubit, 2020-03-31:
I refactored the PCB Modifications [page](https://github.com/sinara-hw/Sayma_AMC/wiki/Sayma-v2.0-PCB-modifications). Needs sign off by @marmeladapk. In particular as to which release is the reference point for that page. See comment on the wiki.

jbqubit, 2020-03-31:
Before refactor. 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

marmeladapk, 2020-04-01:
@jbqubit, I'm afraid that your refactors made this table completely unreadable and more difficult to maintain than it should be (and it's not only my opinion). I'd be in favour to keep the old format and just add information which boards base on which release.

jbqubit, 2020-04-01:
The information content in the old version and the refactored version are the same. The refactored version follows the coding practice of not repeating identical text string throughout code. It is also much easier to extend and annotate changes that apply to more than one board without errors creeping in. For example, there's a natural place to explain "R91->100K."

Definitely think we need to state the baseline release. Do you agree with "[v2.0rc8]"?

marmeladapk, 2020-04-03:
First two Saymas were based on rc8, rest on 2.0.1 (which was a BoM change).

> The information content in the old version and the refactored version are the same. The refactored version follows the coding practice of not repeating identical text string throughout code.

I'm not saying it isn't. But reading and writing isn't programming and repeating R91->100K is way easier to interpret than looking up what does M5 or C0 mean, especially since they do not fit in one screen.

Right now, when looking at the table I only see a bunch of repeated "yes" which tell me nothing unless I look up each item individually. Even worse to maintain are things that appear only in one board, as they clutter "namespace" while these are mostly notes.

We don't have 300 boards to maintain in this table. Let's not complicate my life for the sake of good coding practice applied to documentation.

marmeladapk, 2020-05-04:
@jbqubit Please check if this format is ok.

jbqubit, 2020-05-04:
Thanks for the update. Looks easier to read than what I proposed.

marmeladapk, 2020-05-04:
@jbqubit We have some space for ~2 additional columns in the first table. Do you have any idea for information that would be useful to cross-compare between boards?

Closed 2020-05-04.

Thread 152 (2020-07-08):

Si5324 fails to ack

sbourdeauducq, 2020-07-08:
Sometimes happens on some boards:
```
[     0.011435s]  INFO(satman): gateware ident 6.7258.3f0cf6e6.beta;satellite
panic at src/libcore/result.rs:945:5: cannot initialize Si5324:
"Si5324 failed to ack write address"
```

hartytp, 2020-07-08:
This is currently blocking me from playing with Sayma. Related to the issue on Kasli?

marmeladapk, 2020-07-10:
@sbourdeauducq Are you sure it's happening on AMC? On my end it's happening on RTM.

Thread 155 (2020-07-30):

R233 should be connected to VCCINT not P3V3

marmeladapk, 2020-07-30:
> Connect directly to VCCINT for a shorter TPOR time if required and if supported by the power-up timing of the configuration data source. Connect to GND for standard longer POR delay.

POR_override should also be tied to GND not through pulldown resistor.

Thread 156 (2021-09-06):

Possible typo in I2C mux address mapping

HarryMakes, 2021-09-06:
On page 9 of the latest version of [Sayma AMC schematic](https://github.com/sinara-hw/Sayma_AMC/releases/download/v2.0.1/Sayma_AMC.PDF), the table describing the I2C addresses for the two TCA9548ARGER muxes are incorrect. The **correct** description should read:

> **FPGA I2C** and **MMC I2C2**, addr 1110 A2 A1 **0**
**MMC I2C1**, addr 1110 A2 A1 **1**
where A2=P2[28], A1=P2[29]
default addr is 0x70 and 0x71

Similar issue: https://github.com/sinara-hw/Metlino/issues/72
