sinara-hw/Sayma_AMC/(list of files, drawings)

Other design files:
AMC_Connector.SchDoc
CPU_LPC1776.SchDoc
CPU_LPC1776_SUP_PROG.SchDoc
DDMTD.SchDoc
DUAL_IO_TTL_BUFFER.SchDoc
ETH_PHY_RGMII.SchDoc
FMC_connector.SchDoc
FPGA_Bank_0_CFG.SchDoc
FPGA_Bank_66_HP.SchDoc
FPGA_Banks_44_45_46_DDR64.SchDoc
FPGA_Banks_47_48_HP_FMC.SchDoc
FPGA_Banks_64_65_HR.SchDoc
FPGA_Banks_67_68_DDR32.SchDoc
FPGA_Banks_224_225_226_227_228.SchDoc
FPGA_Decoupling.SchDoc
FPGA_GND_NC.SchDoc
FPGA_Power.SchDoc
I2C_MUX.SchDoc
JTAG_Configuration.SchDoc
M-LVDS_PHY.SchDoc
POWER_Management.SchDoc
PWR_0V9_20A.SchDoc
PWR_DC_DC_EXAR.SchDoc
QUAD_BUCK.SchDoc
RTM_CON.SchDoc
Sayma_AMC.PrjPcb
Sayma_AMC.SchDoc
SDRAM_DDR3_2x16.SchDoc
SDRAM_DDR3_4x16.SchDoc
SFP.SchDoc
SI5324_CDR_WR_oscillators.SchDoc
Thermometers.SchDoc
USB_SERIAL_QUAD.SchDoc
