sinara-hw/Sayma_AMC/(commit log)

2019-02-27 AD19 version
    [AMC_Connector.SchDoc, CPU_LPC1776.SchDoc, CPU_LPC1776_SUP_PROG.SchDoc, DUAL_IO_TTL_BUFFER.SchDoc, ETH_PHY_RGMII.SchDoc, FMC_connector.SchDoc, FPGA_Bank_0_CFG.SchDoc, FPGA_Bank_66_HP.SchDoc]
2019-04-01 added missihg harness filees
    [FPGA_Bank_66_HP.SchDoc, FPGA_Banks_224_225_226_227_228.SchDoc, FPGA_Banks_44_45_46_DDR64.SchDoc, SI5324_CDR_WR_oscillators.SchDoc, Sayma_AMC.PrjPcb]
2019-04-29 added length matching rules, some PI issues resolved. added Hyperlynx config files.
    [CPU_LPC1776.SchDoc, DDMTD.SchDoc, FMC_connector.SchDoc, POWER_Management.SchDoc, PWR_0V9_20A.SchDoc, PWR_DC_DC_EXAR.SchDoc, SDRAM_DDR3_4x16.SchDoc, SFP.SchDoc]
2019-09-30 Sayma v2.0.1 Implemented BoM changes after initial testing Close #130 Close #127 Close #126 (DNPed termination resistor as a temporary fix)
    [FPGA_Bank_0_CFG.SchDoc, POWER_Management.SchDoc, Sayma_AMC.PrjPcb]
